Teruru-52/Mercury-pcb/v3.0/dxf/blmd_v1.dxf

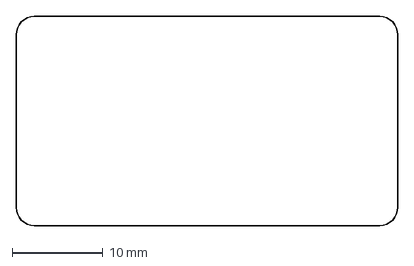
[picture p1: CAD file, 2025-02-25]
v3.0/dxf/blmd_v1.dxf
42.0 x 23.0 mm
