Teruru-52/Mercury-pcb/v3.0/dxf/encoder.dxf

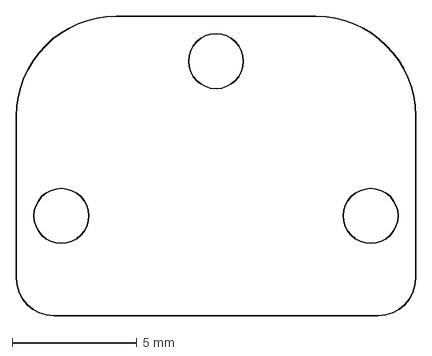
[picture p2: CAD file, 2025-02-25]
v3.0/dxf/encoder.dxf
16.0 x 12.0 mm
