Teruru-52/Mercury-pcb/v1.0/dxf/top_board.dxf

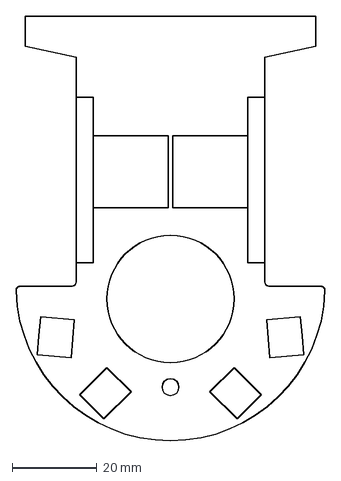
[picture p3: CAD file, 2025-02-25, an earlier design]
v1.0/dxf/top_board.dxf
72.8 x 100.0 mm
