Teruru-52/Mercury-pcb/(list of files, drawings)

Other design files:
v1.0/Quatro.dsn
