Teruru-52/Mercury-pcb/v1.0/Quatro.kicad_pcb

## KiCad design v1.0/Quatro.kicad_pcb (2025-02-25, an earlier design)

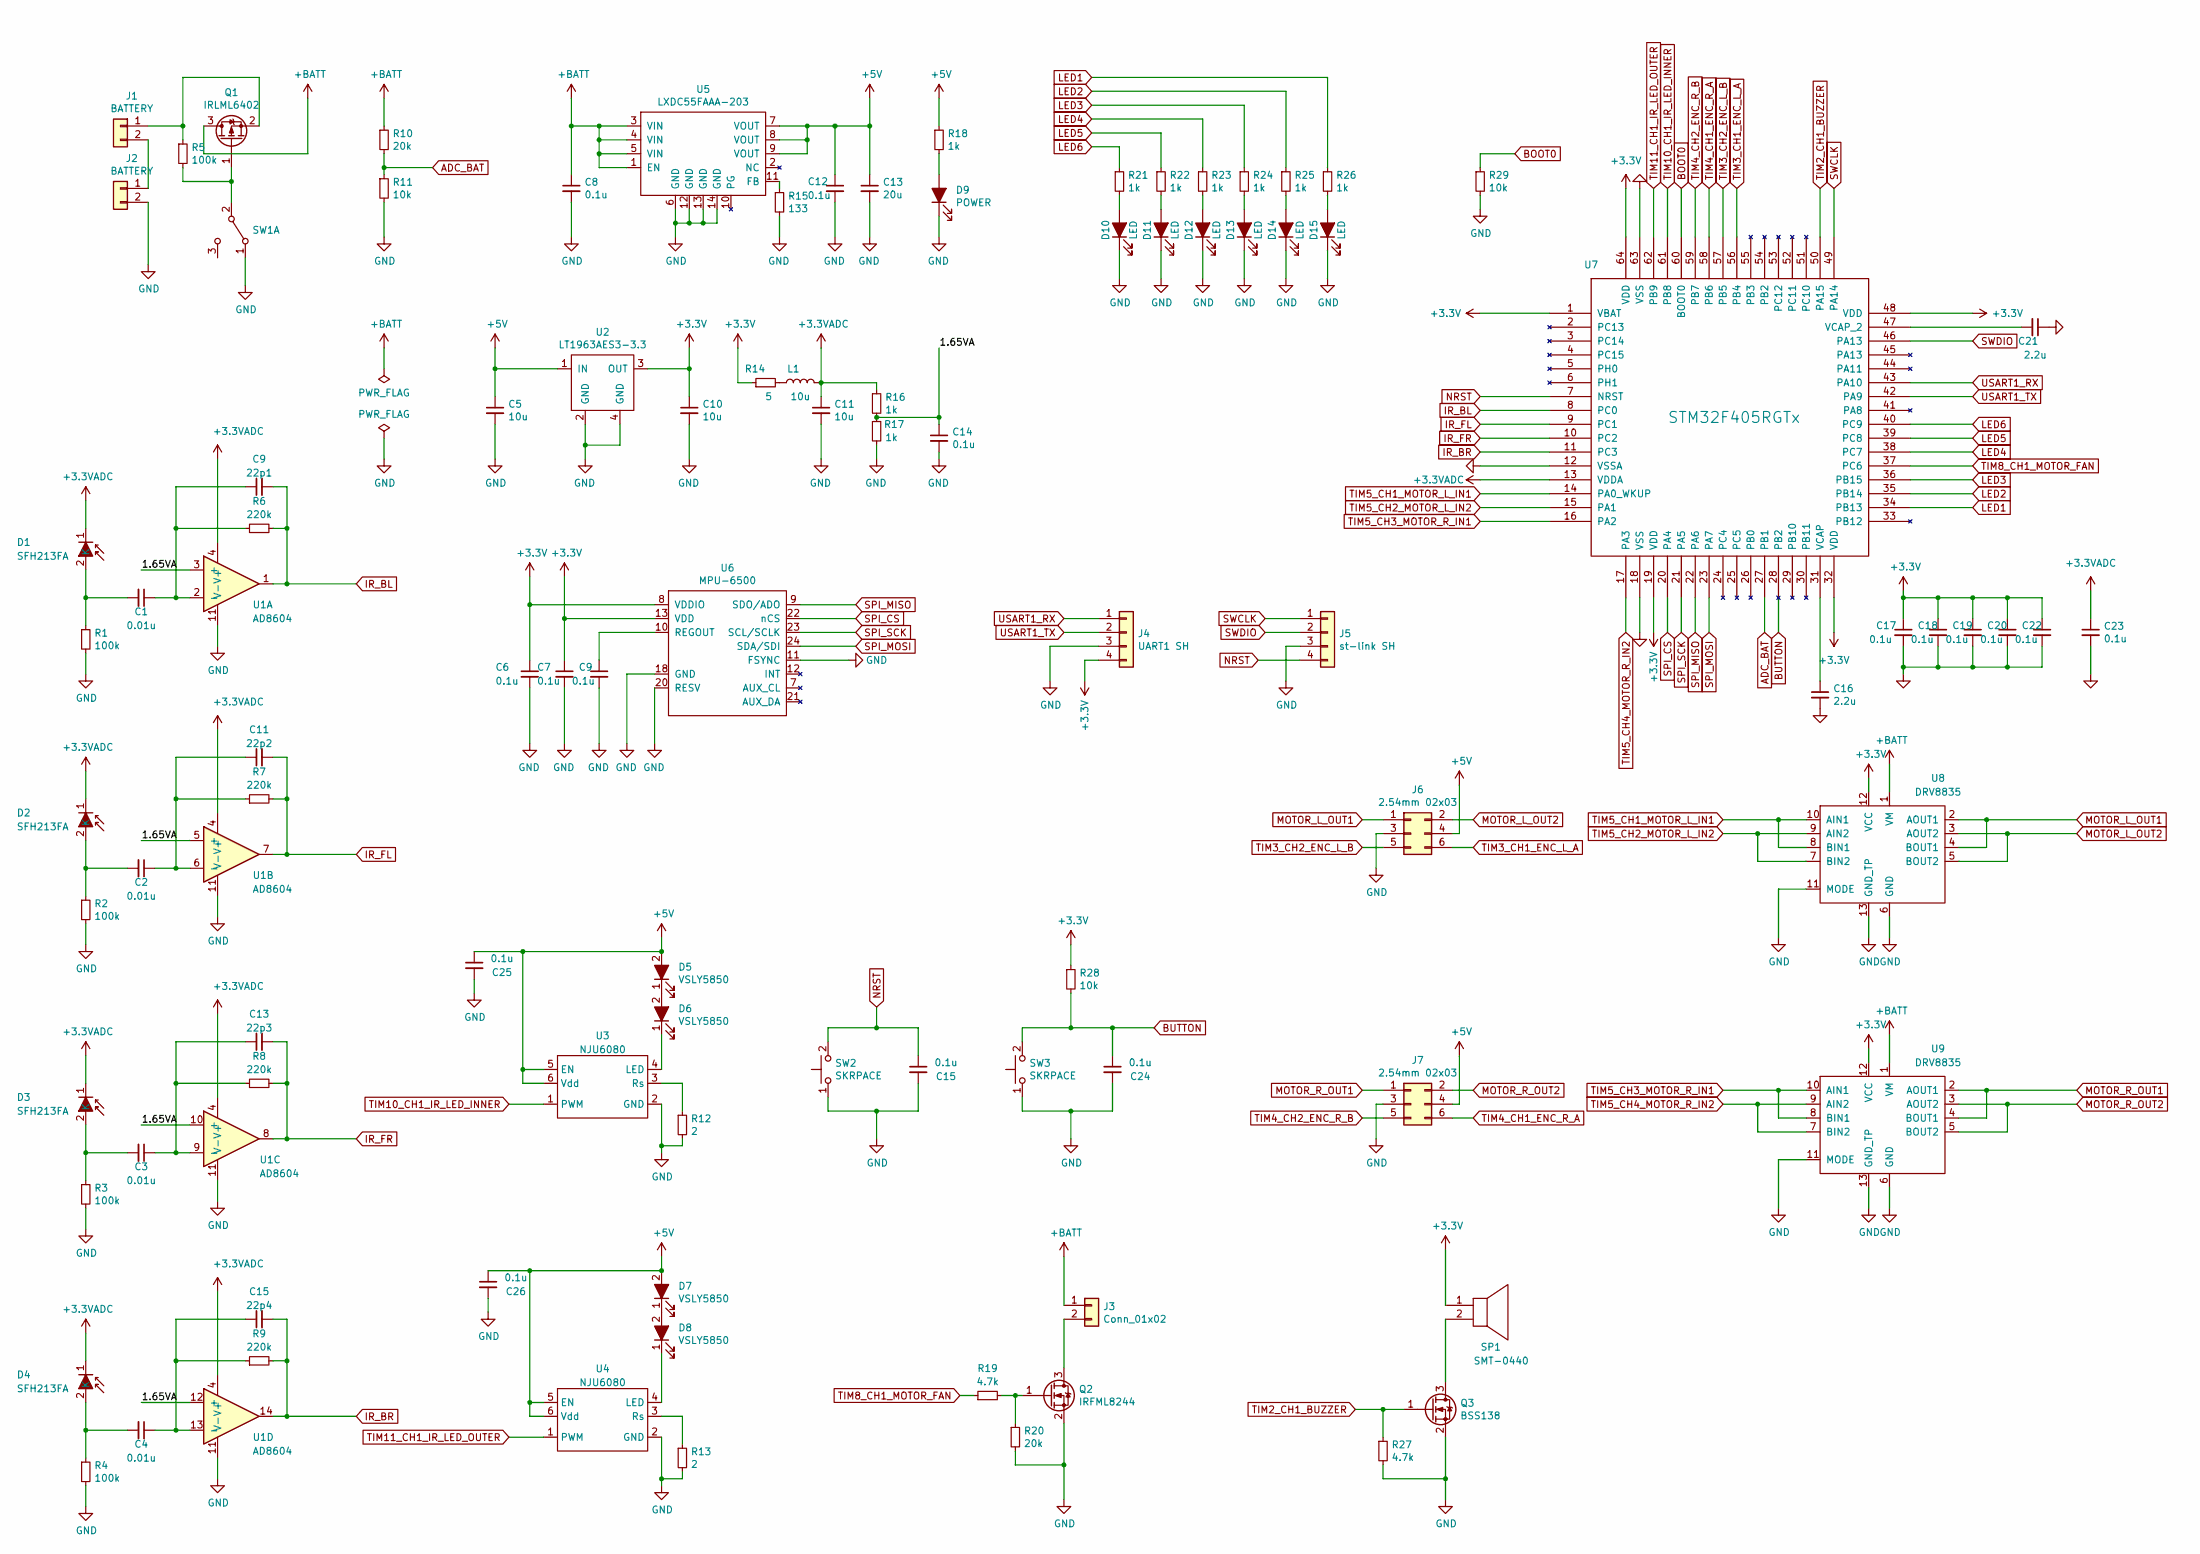
[picture p5: schematic Quatro.kicad_sch]

Parts:
22p1: C9; C_0603_1608Metric_Pad1.08x0.95mm_HandSolder
22p2: C11; C_0603_1608Metric_Pad1.08x0.95mm_HandSolder
22p3: C13; C_0603_1608Metric_Pad1.08x0.95mm_HandSolder
22p4: C15; C_0603_1608Metric_Pad1.08x0.95mm_HandSolder
C1, C2, C3, C4: 0.01u; C_0603_1608Metric_Pad1.08x0.95mm_HandSolder
C5, C10, C11: 10u; C_0603_1608Metric_Pad1.08x0.95mm_HandSolder
C6, C7, C8, C9, C12, C14, C15, C17, C18, C19, C20, C22, C23, C24, C25, C26: 0.1u; C_0603_1608Metric_Pad1.08x0.95mm_HandSolder
C13: 20u; C_0603_1608Metric_Pad1.08x0.95mm_HandSolder
C16, C21: 2.2u; C_0603_1608Metric_Pad1.08x0.95mm_HandSolder
D1, D2, D3, D4: SFH213FA; D_T-1_P2.54mm_Vertical_AnodeUp
D5, D6, D7, D8: VSLY5850; D_T-1_P2.54mm_Vertical_AnodeUp
D9: POWER; LED_0603_1608Metric_Pad1.05x0.95mm_HandSolder
D10, D11, D12, D13, D14, D15: LED; LED_0603_1608Metric_Pad1.05x0.95mm_HandSolder
J1, J2: BATTERY; PinSocket_1x02_P1.27mm_Vertical
J3: Conn_01x02; PinSocket_1x02_P1.27mm_Vertical
J4: UART1 SH; PinHeader_1x04_P2.54mm_Vertical
J5: st-link SH; JST_SH_BM04B-SRSS-TB_1x04-1MP_P1.00mm_Vertical
J6, J7: 2.54mm 02x03; PinHeader_2x03_P2.54mm_Vertical
L1: 10u; L_1210_3225Metric_Pad1.42x2.65mm_HandSolder
Q1: IRLML6402; SOT-23
Q2: IRFML8244; SOT-23
Q3: BSS138; SOT-23
R1, R2, R3, R4, R5: 100k; R_0805_2012Metric_Pad1.20x1.40mm_HandSolder
R6, R7, R8, R9: 220k; R_0603_1608Metric_Pad0.98x0.95mm_HandSolder
R10, R20: 20k; R_0603_1608Metric_Pad0.98x0.95mm_HandSolder
R11, R29: 10k; R_0805_2012Metric_Pad1.20x1.40mm_HandSolder
R12, R13: 2; R_0805_2012Metric_Pad1.20x1.40mm_HandSolder
R14: 5; R_0805_2012Metric_Pad1.20x1.40mm_HandSolder
R15: 133; R_1206_3216Metric_Pad1.30x1.75mm_HandSolder
R16, R17, R18, R21, R22, R23, R24, R25, R26: 1k; R_0805_2012Metric_Pad1.20x1.40mm_HandSolder
R19, R27: 4.7k; R_0603_1608Metric_Pad0.98x0.95mm_HandSolder
R28: 10k; R_0603_1608Metric_Pad0.98x0.95mm_HandSolder
SP1: SMT-0440; SMT-0440-T-R
SW1: SW_DPDT_x2; SlideSwitch
SW2, SW3: SKRPACE; SW_Push_1P1T_NO_Vertical_Wuerth_434133025816
U1: AD8604; TSSOP-14_4.4x5mm_P0.65mm
U2: LT1963AES3-3.3; SOT-223
U3, U4: NJU6080; SOT-23-6_Handsoldering
U5: LXDC55FAAA-203
U6: MPU-6500; QFN-24-1EP_3x3mm_P0.4mm_EP1.75x1.6mm
U7: STM32F405RGTx; LQFP-64_10x10mm_P0.5mm
U8, U9: DRV8835

Connections:
+3.3V: C6.1, C7.1, C10.1, C17.1, C18.1, C19.1, C20.1, C22.1, J4.4, R14.1, R28.1, SP1.1, U2.3 (OUT), U6.8 (VDDIO), U6.13 (VDD), U7.1 (VBAT), U7.19 (VDD), U7.32 (VDD), U7.48 (VDD), U7.64 (VDD), U8.12 (VCC), U9.12 (VCC)
+3.3VADC: C11.1, C23.1, D1.1 (K), D2.1 (K), D3.1 (K), D4.1 (K), L1.2, R16.1, U1.4 (V+), U7.13 (VDDA)
+5V: C5.1, C12.1, C13.1, C25.1, C26.1, D5.2, D7.2, J6.4, J7.4, R18.1, U2.1 (IN), U3.5 (EN), U3.6 (Vdd), U4.5 (EN), U4.6 (Vdd), U5.7 (VOUT), U5.8 (VOUT), U5.9 (VOUT)
+BATT: C8.1, J3.1, Q1.3 (D), R10.1, U5.1 (EN), U5.3 (VIN), U5.4 (VIN), U5.5 (VIN), U8.1 (VM), U9.1 (VM)
/1.65VA: C14.1, R16.2, R17.1, U1.3 (+), U1.5 (+), U1.10 (+), U1.12 (+)
ADC_BAT: R10.2, R11.1, U7.27 (PB1)
BOOT0: R29.1, U7.60 (BOOT0)
BUTTON: C24.1, R28.2, SW3.2, U7.28 (PB2)
GND: C5.2, C6.2, C7.2, C8.2, C9.2, C10.2, C11.2, C12.2, C13.2, C14.2, C15.2, C16.2, C17.2, C18.2, C19.2, C20.2, C21.1, C22.2, C23.2, C24.2, C25.2, C26.2, D9.1 (K), D10.1 (K), D11.1 (K), D12.1 (K), D13.1 (K), D14.1 (K), D15.1 (K), J2.2, J4.3, J5.3, J6.3, J7.3, Q2.2, Q3.2 (S), R1.2, R2.2, R3.2, R4.2, R11.2, R12.2, R13.2, R15.2, R17.2, R20.2, R27.2, R29.2, SW1.1 (A), SW2.1, SW3.1, U1.11 (V-), U2.2 (GND), U2.4 (GND), U3.2 (GND), U4.2 (GND), U5.6 (GND), U5.12 (GND), U5.13 (GND), U5.14 (GND), U6.11 (FSYNC), U6.18 (GND), U6.20 (RESV), U7.12 (VSSA), U7.18 (VSS), U7.63 (VSS), U8.6 (GND), U8.11 (MODE), U8.13 (GND_TP), U9.6 (GND), U9.11 (MODE), U9.13 (GND_TP)
IR_BL: 22p1.2, R6.2, U1.1, U7.8 (PC0)
IR_BR: 22p4.2, R9.2, U1.14, U7.11 (PC3)
IR_FL: 22p2.2, R7.2, U1.7, U7.9 (PC1)
IR_FR: 22p3.2, R8.2, U1.8, U7.10 (PC2)
LED1: R26.1, U7.34 (PB13)
LED2: R25.1, U7.35 (PB14)
LED3: R24.1, U7.36 (PB15)
LED4: R23.1, U7.38 (PC7)
LED5: R22.1, U7.39 (PC8)
LED6: R21.1, U7.40 (PC9)
MOTOR_L_OUT1: J6.1, U8.2 (AOUT1), U8.4 (BOUT1)
MOTOR_L_OUT2: J6.2, U8.3 (AOUT2), U8.5 (BOUT2)
MOTOR_R_OUT1: J7.1, U9.2 (AOUT1), U9.4 (BOUT1)
MOTOR_R_OUT2: J7.2, U9.3 (AOUT2), U9.5 (BOUT2)
NRST: C15.1, J5.4, SW2.2, U7.7 (NRST)
unnamed: 22p1.1, C1.1, R6.1, U1.2 (-)
unnamed: 22p2.1, C2.1, R7.1, U1.6 (-)
unnamed: 22p3.1, C3.1, R8.1, U1.9 (-)
unnamed: 22p4.1, C4.1, R9.1, U1.13 (-)
unnamed: C1.2, D1.2, R1.1
unnamed: C2.2, D2.2, R2.1
unnamed: C3.2, D3.2, R3.1
unnamed: C4.2, D4.2, R4.1
unnamed: C9.1, U6.10 (REGOUT)
unnamed: C16.1, U7.31 (VCAP)
unnamed: C21.2, U7.47 (VCAP_2)
unnamed: D5.1, D6.2
unnamed: D6.1, U3.4 (LED)
unnamed: D7.1, D8.2
unnamed: D8.1, U4.4 (LED)
unnamed: D9.2 (A), R18.2
unnamed: D10.2 (A), R21.2
unnamed: D11.2 (A), R22.2
unnamed: D12.2 (A), R23.2
unnamed: D13.2 (A), R24.2
unnamed: D14.2 (A), R25.2
unnamed: D15.2 (A), R26.2
unnamed: J1.1, Q1.2 (S), R5.1
unnamed: J1.2, J2.1
unnamed: J3.2, Q2.3
unnamed: L1.1, R14.2
unnamed: Q1.1 (G), R5.2, SW1.2 (B)
unnamed: Q2.1, R19.2, R20.1
unnamed: Q3.3 (D), SP1.2
unnamed: R12.1, U3.3 (Rs)
unnamed: R13.1, U4.3 (Rs)
unnamed: R15.1, U5.11 (FB)
SPI_CS: U6.22 (nCS), U7.20 (PA4)
SPI_MISO: U6.9 (SDO/ADO), U7.22 (PA6)
SPI_MOSI: U6.24 (SDA/SDI), U7.23 (PA7)
SPI_SCK: U6.23 (SCL/SCLK), U7.21 (PA5)
SWCLK: J5.1, U7.49 (PA14)
SWDIO: J5.2, U7.46 (PA13)
TIM2_CH1_BUZZER: Q3.1 (G), R27.1, U7.50 (PA15)
TIM3_CH1_ENC_L_A: J6.6, U7.56 (PB4)
TIM3_CH2_ENC_L_B: J6.5, U7.57 (PB5)
TIM4_CH1_ENC_R_A: J7.6, U7.58 (PB6)
TIM4_CH2_ENC_R_B: J7.5, U7.59 (PB7)
TIM5_CH1_MOTOR_L_IN1: U7.14 (PA0_WKUP), U8.8 (BIN1), U8.10 (AIN1)
TIM5_CH2_MOTOR_L_IN2: U7.15 (PA1), U8.7 (BIN2), U8.9 (AIN2)
TIM5_CH3_MOTOR_R_IN1: U7.16 (PA2), U9.8 (BIN1), U9.10 (AIN1)
TIM5_CH4_MOTOR_R_IN2: U7.17 (PA3), U9.7 (BIN2), U9.9 (AIN2)
TIM8_CH1_MOTOR_FAN: R19.1, U7.37 (PC6)
TIM10_CH1_IR_LED_INNER: U3.1 (PWM), U7.61 (PB8)
TIM11_CH1_IR_LED_OUTER: U4.1 (PWM), U7.62 (PB9)
USART1_RX: J4.1, U7.43 (PA10)
USART1_TX: J4.2, U7.42 (PA9)

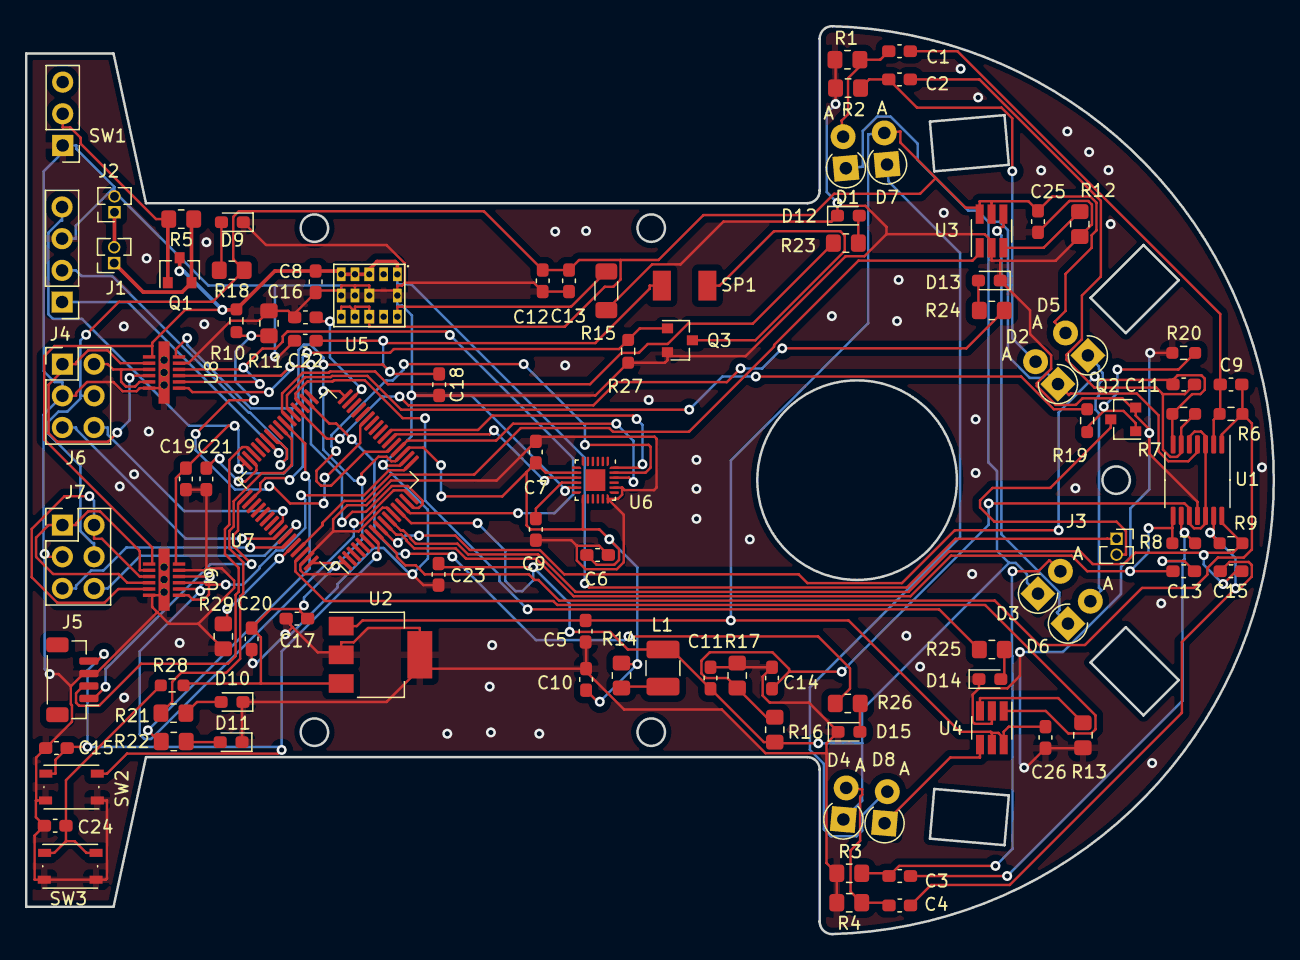
[picture p6: board Quatro.kicad_pcb from above]

Board: 2 copper layers, 100.0 x 72.8 mm, 98 parts (0 on the bottom side), 76 nets.
