Teruru-52/Mercury-pcb/v3.0/encoder/encoder.kicad_pcb

## KiCad design v3.0/encoder/encoder.kicad_pcb (2025-02-25)

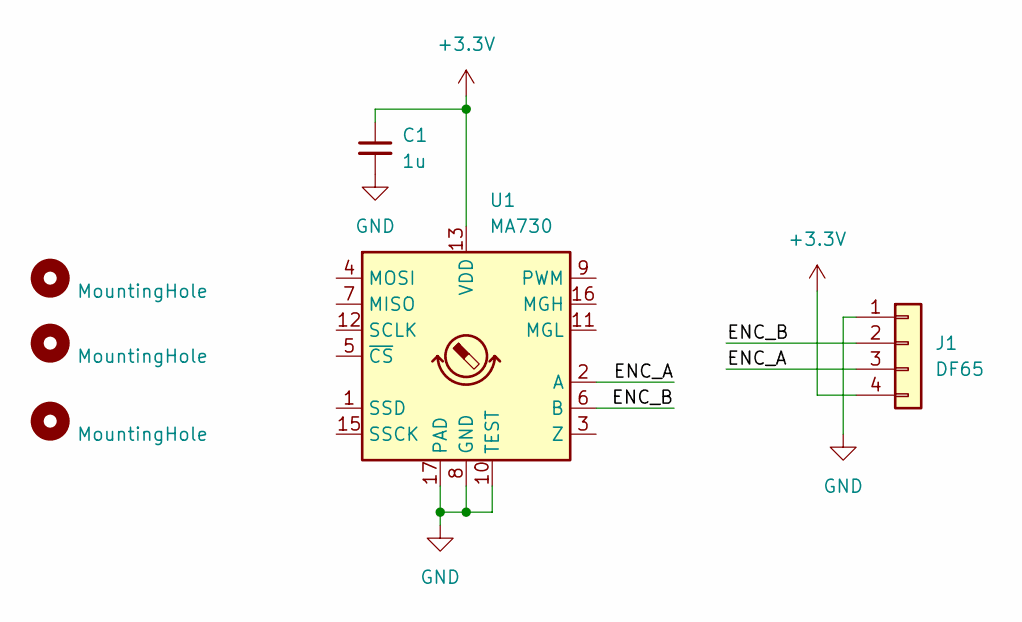
[picture p7: schematic encoder.kicad_sch]

Parts:
C1: 1u; C_0603_1608Metric
H1, H2, H3: MountingHole; MountingHole_2.2mm_M2
J1: DF65; DF65-4P
U1: MA730; QFN-16-1EP_3x3mm_P0.5mm_EP1.75x1.75mm

Connections:
+3.3V: C1.1, J1.4, U1.13 (VDD)
/ENC_A: J1.3, U1.2 (A)
/ENC_B: J1.2, U1.6 (B)
GND: C1.2, J1.1, U1.8 (GND), U1.10 (TEST), U1.17 (PAD)

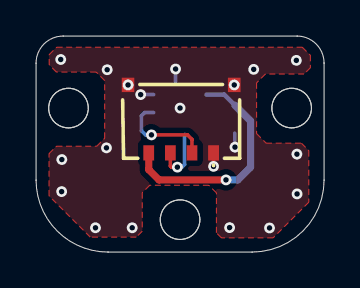
[picture p8: board encoder.kicad_pcb from above]

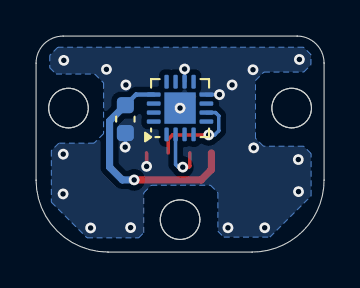
[picture p9: board encoder.kicad_pcb from below]

Board: 2 copper layers, 16.0 x 12.0 mm, 6 parts (2 on the bottom side), 4 nets.
