Teruru-52/Mercury-pcb/v2.1/Mercury-v2.1-pcb.kicad_pcb

## KiCad design v2.1/Mercury-v2.1-pcb.kicad_pcb (2025-02-25, an earlier design)

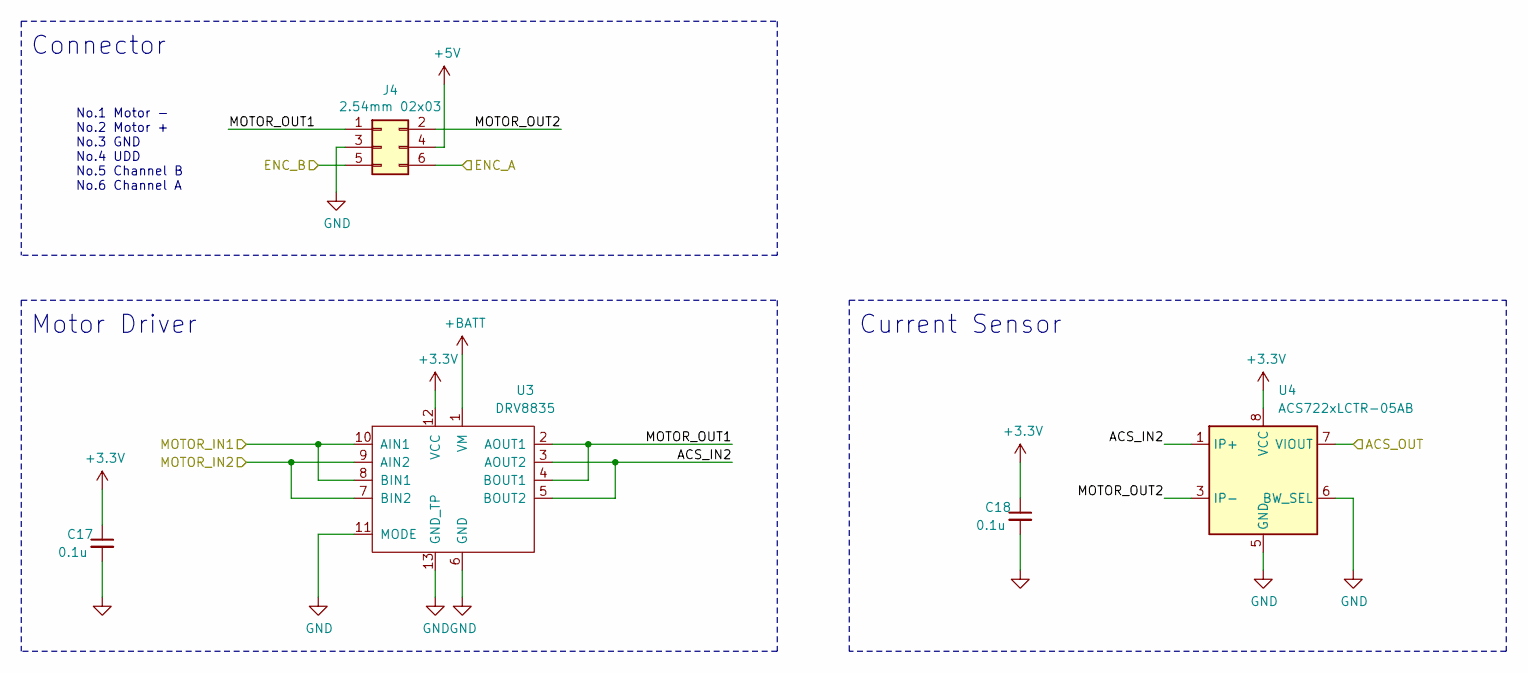
[picture p10: schematic motor_driver.kicad_sch]

Parts:
C17, C18: 0.1u; C_0201_0603Metric
J4: 2.54mm 02x03; PinHeader_2x03_P2.54mm_Vertical
U3: DRV8835; DRV8835DSSR
U4: ACS722xLCTR-05AB; SOIC-8_3.9x4.9mm_P1.27mm

Connections:
+3.3V: C17.1, C18.1, U3.12 (VCC), U4.8 (VCC); also elsewhere on the board
+5V: J4.4; also elsewhere on the board
+BATT: U3.1 (VM); also elsewhere on the board
/mcu/ACS_IN_L: U4.7 (VIOUT); also elsewhere on the board
/mcu/ENC_L_A: J4.6; also elsewhere on the board
/mcu/END_L_B: J4.5; also elsewhere on the board
/mcu/MOTOR_L_IN1: U3.8 (BIN1), U3.10 (AIN1); also elsewhere on the board
/mcu/MOTOR_L_IN2: U3.7 (BIN2), U3.9 (AIN2); also elsewhere on the board
/motor_driver L/ACS_IN2: U3.3 (AOUT2), U3.5 (BOUT2), U4.1 (IP+), U4.2 (IP+)
/motor_driver L/MOTOR_OUT1: J4.1, U3.2 (AOUT1), U3.4 (BOUT1)
/motor_driver L/MOTOR_OUT2: J4.2, U4.3 (IP-), U4.4 (IP-)
GND: C17.2, C18.2, J4.3, U3.6 (GND), U3.11 (MODE), U3.13 (GND_TP), U4.5 (GND), U4.6 (BW_SEL); also elsewhere on the board

Parts of its further copies:
C39, C40: 0.1u; C_0201_0603Metric
J7: 2.54mm 02x03; PinHeader_2x03_P2.54mm_Vertical
U11: DRV8835; DRV8835DSSR
U12: ACS722xLCTR-05AB; SOIC-8_3.9x4.9mm_P1.27mm

Connections of its further copies:
+3.3V: C39.1, C40.1, U11.12 (VCC), U12.8 (VCC); also elsewhere on the board
+5V: J7.4; also elsewhere on the board
+BATT: U11.1 (VM); also elsewhere on the board
/mcu/ACS_IN_R: U12.7 (VIOUT); also elsewhere on the board
/mcu/ENC_R_A: J7.6; also elsewhere on the board
/mcu/END_R_B: J7.5; also elsewhere on the board
/mcu/MOTOR_R_IN1: U11.8 (BIN1), U11.10 (AIN1); also elsewhere on the board
/mcu/MOTOR_R_IN2: U11.7 (BIN2), U11.9 (AIN2); also elsewhere on the board
/motor_driver R/ACS_IN2: U11.3 (AOUT2), U11.5 (BOUT2), U12.1 (IP+), U12.2 (IP+)
/motor_driver R/MOTOR_OUT1: J7.1, U11.2 (AOUT1), U11.4 (BOUT1)
/motor_driver R/MOTOR_OUT2: J7.2, U12.3 (IP-), U12.4 (IP-)
GND: C39.2, C40.2, J7.3, U11.6 (GND), U11.11 (MODE), U11.13 (GND_TP), U12.5 (GND), U12.6 (BW_SEL); also elsewhere on the board

Notes on the sheet:
Connector
No.1 Motor - No.2 Motor + No.3 GND No.4 UDD No.5 Channel B No.6 Channel A
Current Sensor
Motor Driver

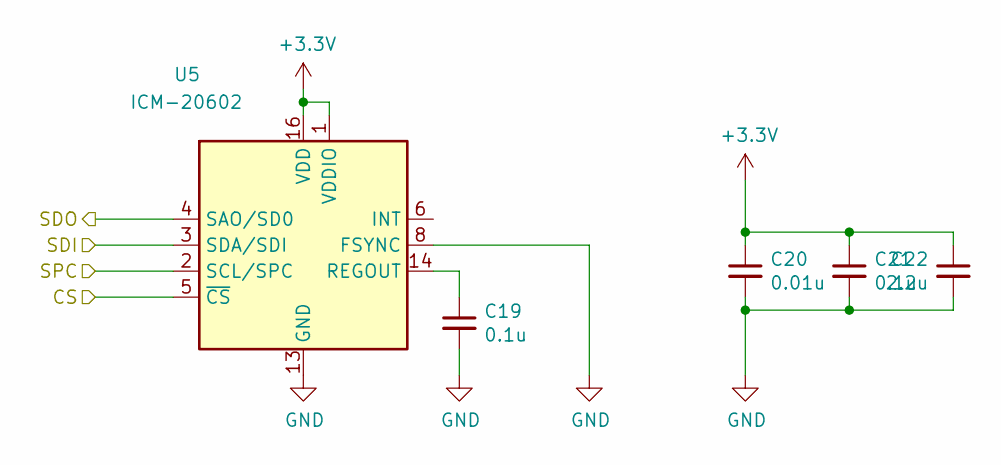
[picture p11: schematic imu.kicad_sch]

Parts:
C19, C21: 0.1u; C_0201_0603Metric
C20: 0.01u; C_0201_0603Metric
C22: 2.2u; C_0402_1005Metric
U5: ICM-20602; LGA-16_3x3mm_P0.5mm_LayoutBorder3x5y

Connections:
+3.3V: C20.1, C21.1, C22.1, U5.1 (VDDIO), U5.16 (VDD); also elsewhere on the board
/imu/CS: U5.5 (~CS); also elsewhere on the board
/imu/SDI: U5.3 (SDA/SDI); also elsewhere on the board
/imu/SDO: U5.4 (SAO/SD0); also elsewhere on the board
/imu/SPC: U5.2 (SCL/SPC); also elsewhere on the board
GND: C19.2, C20.2, C21.2, C22.2, U5.8 (FSYNC), U5.9 (GND), U5.10 (GND), U5.11 (GND), U5.12 (GND), U5.13 (GND), U5.15 (GND); also elsewhere on the board
unnamed: C19.1, U5.14 (REGOUT)

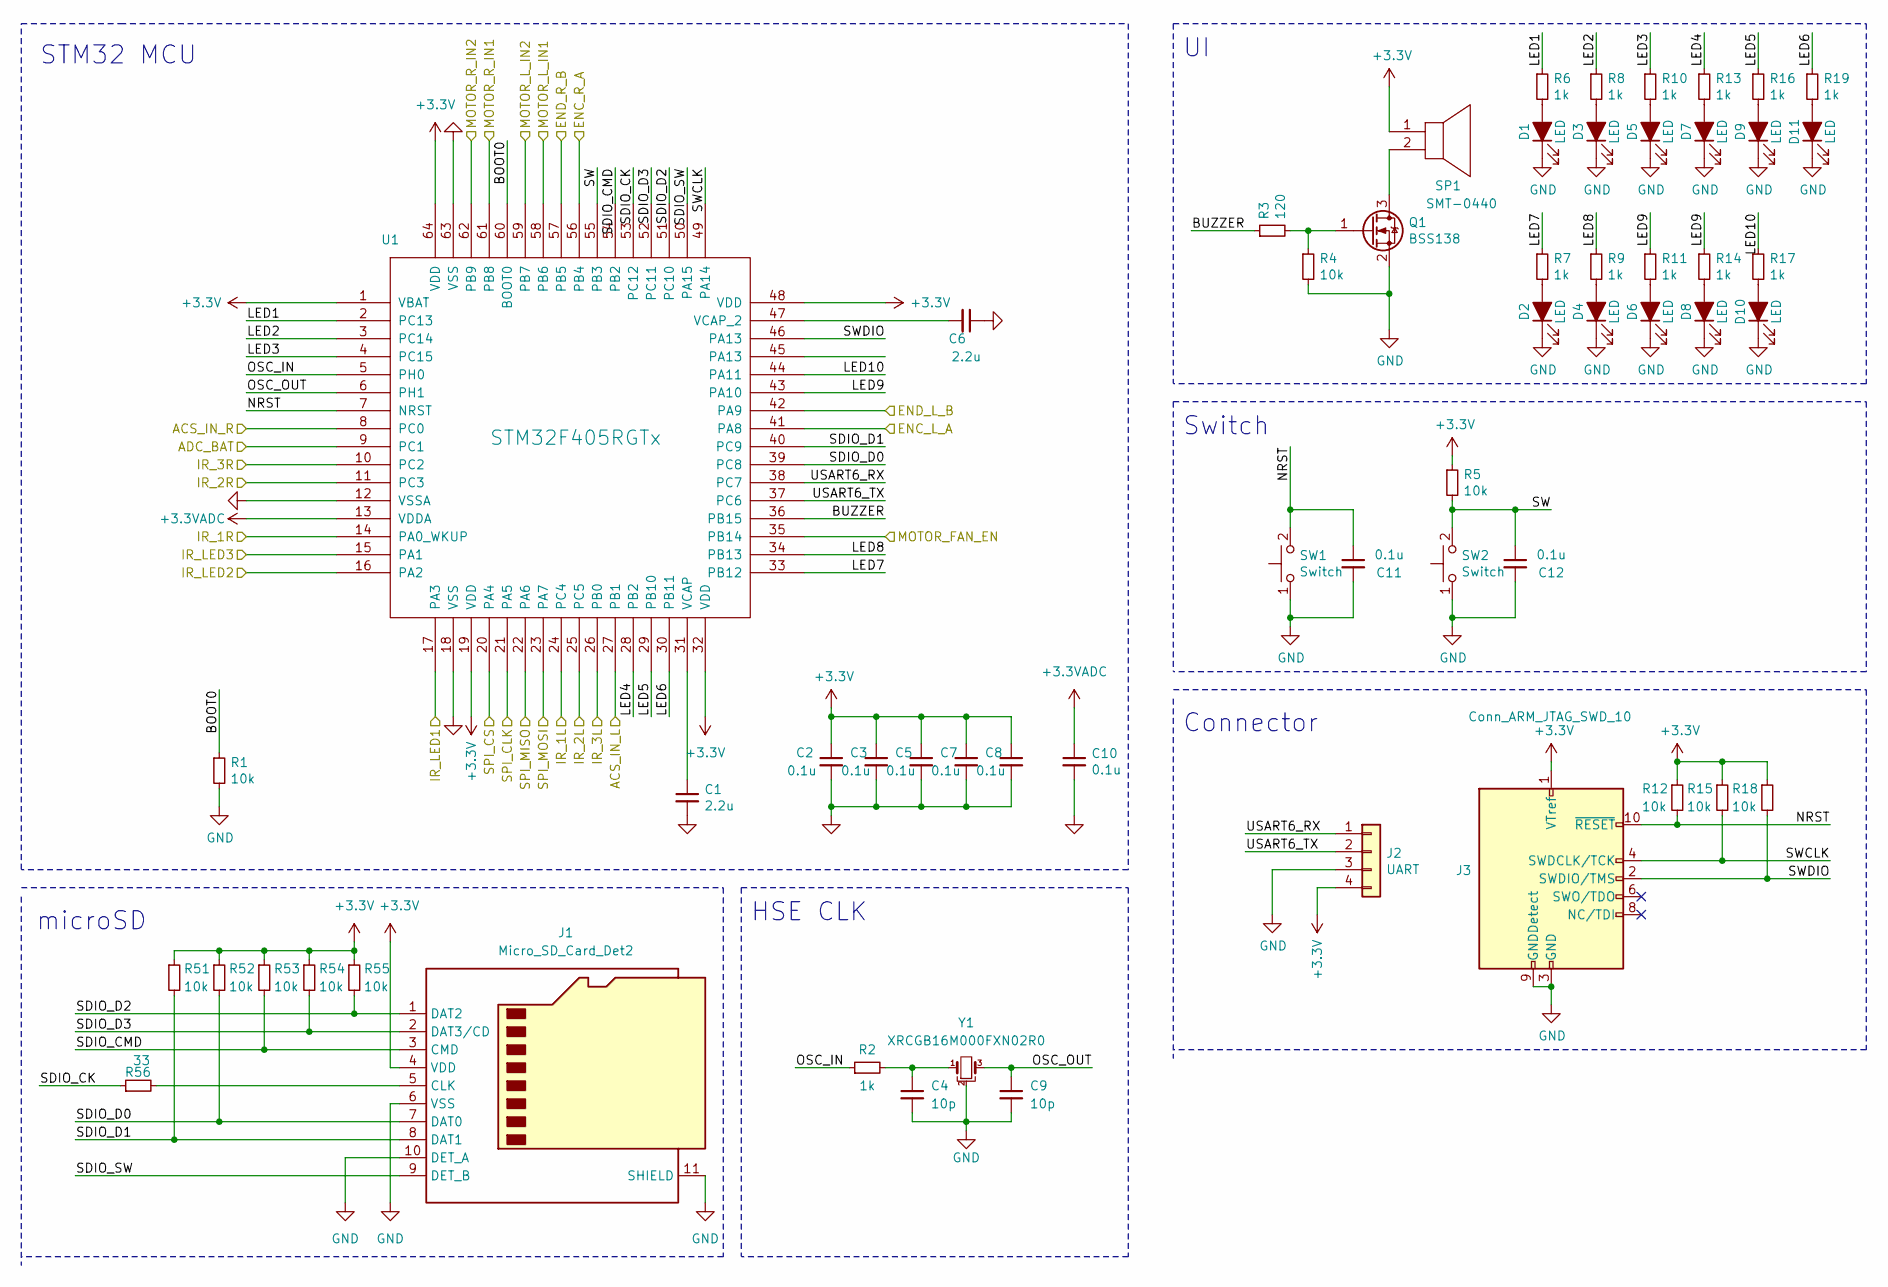
[picture p12: schematic mcu.kicad_sch]

Parts:
C1, C6: 2.2u; C_0402_1005Metric
C2, C3, C5, C7, C8, C10, C11, C12: 0.1u; C_0201_0603Metric
C4, C9: 10p; C_0402_1005Metric_Pad0.74x0.62mm_HandSolder
D1, D2, D3, D4, D5, D6, D7, D8, D9, D10, D11: LED; LED_0402_1005Metric
J1: Micro_SD_Card_Det2; microSD_HC_Hirose_DM3AT-SF-PEJM5
J2: UART; PinHeader_1x04_P2.54mm_Vertical
J3: Conn_ARM_JTAG_SWD_10; mylib
Q1: BSS138; SOT-23
R1, R4, R5, R12, R15, R18, R51, R52, R53, R54, R55: 10k; R_0201_0603Metric
R2: 1k; R_0402_1005Metric_Pad0.72x0.64mm_HandSolder
R3: 120; R_0201_0603Metric
R6, R7, R8, R9, R10, R11, R13, R14, R16, R17, R19: 1k; R_0201_0603Metric
R56: 33; R_0201_0603Metric
SP1: SMT-0440
SW1, SW2: Switch; TVAF06A020BR
U1: STM32F405RGTx; LQFP-64_10x10mm_P0.5mm
Y1: XRCGB16M000FXN02R0

Connections:
+3.3V: C2.1, C3.1, C5.1, C7.1, C8.1, J1.4 (VDD), J2.4, J3.1 (VTref), R5.1, R12.1, R15.1, R18.1, R51.1, R52.1, R53.1, R54.1, R55.1, SP1.1, U1.1 (VBAT), U1.19 (VDD), U1.32 (VDD), U1.48 (VDD), U1.64 (VDD); also elsewhere on the board
+3.3VADC: C10.1, U1.13 (VDDA); also elsewhere on the board
/fan_driver/MOTOR_FAN_EN: U1.35 (PB14); also elsewhere on the board
/imu/CS: U1.20 (PA4); also elsewhere on the board
/imu/SDI: U1.23 (PA7); also elsewhere on the board
/imu/SDO: U1.22 (PA6); also elsewhere on the board
/imu/SPC: U1.21 (PA5); also elsewhere on the board
/ir_led/IR_LED_IN1: U1.16 (PA2); also elsewhere on the board
/ir_led/IR_LED_IN2: U1.15 (PA1); also elsewhere on the board
/ir_led_single/IR_LED_IN: U1.17 (PA3); also elsewhere on the board
/ir_sensor1/IR_OUT_A: U1.11 (PC3); also elsewhere on the board
/ir_sensor1/IR_OUT_B: U1.25 (PC5); also elsewhere on the board
/ir_sensor2/IR_OUT_A: U1.10 (PC2); also elsewhere on the board
/ir_sensor2/IR_OUT_B: U1.26 (PB0); also elsewhere on the board
/ir_sensor/IR_OUT_A: U1.14 (PA0_WKUP); also elsewhere on the board
/ir_sensor/IR_OUT_B: U1.24 (PC4); also elsewhere on the board
/mcu/ACS_IN_L: U1.27 (PB1); also elsewhere on the board
/mcu/ACS_IN_R: U1.8 (PC0); also elsewhere on the board
/mcu/ADC_BAT: U1.9 (PC1); also elsewhere on the board
/mcu/BOOT0: R1.1, U1.60 (BOOT0)
/mcu/BUZZER: R3.1, U1.36 (PB15)
/mcu/ENC_L_A: U1.41 (PA8); also elsewhere on the board
/mcu/ENC_R_A: U1.56 (PB4); also elsewhere on the board
/mcu/END_L_B: U1.42 (PA9); also elsewhere on the board
/mcu/END_R_B: U1.57 (PB5); also elsewhere on the board
/mcu/LED1: R6.1, U1.2 (PC13)
/mcu/LED2: R8.1, U1.3 (PC14)
/mcu/LED3: R10.1, U1.4 (PC15)
/mcu/LED4: R13.1, U1.28 (PB2)
/mcu/LED5: R16.1, U1.29 (PB10)
/mcu/LED6: R19.1, U1.30 (PB11)
/mcu/LED7: R7.1, U1.33 (PB12)
/mcu/LED8: R9.1, U1.34 (PB13)
/mcu/LED9: R11.1, R14.1, U1.43 (PA10)
/mcu/LED10: R17.1, U1.44 (PA11)
/mcu/MOTOR_L_IN1: U1.58 (PB6); also elsewhere on the board
/mcu/MOTOR_L_IN2: U1.59 (PB7); also elsewhere on the board
/mcu/MOTOR_R_IN1: U1.61 (PB8); also elsewhere on the board
/mcu/MOTOR_R_IN2: U1.62 (PB9); also elsewhere on the board
/mcu/NRST: C11.1, J3.10 (~RESET), R12.2, SW1.2, U1.7 (NRST)
/mcu/OSC_IN: R2.1, U1.5 (PH0)
/mcu/OSC_OUT: C9.1, U1.6 (PH1), Y1.3
/mcu/SDIO_CK: R56.1, U1.53 (PC12)
/mcu/SDIO_CMD: J1.3 (CMD), R53.2, U1.54 (PB2)
/mcu/SDIO_D0: J1.7 (DAT0), R52.2, U1.39 (PC8)
/mcu/SDIO_D1: J1.8 (DAT1), R51.2, U1.40 (PC9)
/mcu/SDIO_D2: J1.1 (DAT2), R55.2, U1.51 (PC10)
/mcu/SDIO_D3: J1.2 (DAT3/CD), R54.2, U1.52 (PC11)
/mcu/SDIO_SW: J1.9 (DET_B), U1.50 (PA15)
/mcu/SW: C12.1, R5.2, SW2.2, U1.55 (PB3)
/mcu/SWCLK: J3.4 (SWDCLK/TCK), R15.2, U1.49 (PA14)
/mcu/SWDIO: J3.2 (SWDIO/TMS), R18.2, U1.46 (PA13)
/mcu/USART6_RX: J2.1, U1.38 (PC7)
/mcu/USART6_TX: J2.2, U1.37 (PC6)
GND: C1.2, C2.2, C3.2, C4.2, C5.2, C6.1, C7.2, C8.2, C9.2, C10.2, C11.2, C12.2, D1.1 (K), D2.1 (K), D3.1 (K), D4.1 (K), D5.1 (K), D6.1 (K), D7.1 (K), D8.1 (K), D9.1 (K), D10.1 (K), D11.1 (K), J1.6 (VSS), J1.10 (DET_A), J1.11 (SHIELD), J2.3, J3.3 (GND), J3.5 (GND), J3.9 (GNDDetect), Q1.2 (S), R1.2, R4.2, SW1.1, SW2.1, U1.12 (VSSA), U1.18 (VSS), U1.63 (VSS), Y1.2; also elsewhere on the board
unnamed: C4.1, R2.2, Y1.1
unnamed: D1.2 (A), R6.2
unnamed: D2.2 (A), R7.2
unnamed: D3.2 (A), R8.2
unnamed: D4.2 (A), R9.2
unnamed: D5.2 (A), R10.2
unnamed: D6.2 (A), R11.2
unnamed: D7.2 (A), R13.2
unnamed: D8.2 (A), R14.2
unnamed: D9.2 (A), R16.2
unnamed: D10.2 (A), R17.2
unnamed: D11.2 (A), R19.2
unnamed: J1.5 (CLK), R56.2
unnamed: Q1.3 (D), SP1.2
unnamed: Q1.1 (G), R3.2, R4.1
unnamed: C1.1, U1.31 (VCAP)
unnamed: C6.2, U1.47 (VCAP_2)

Notes on the sheet:
STM32 MCU
microSD
Connector
HSE CLK
Switch

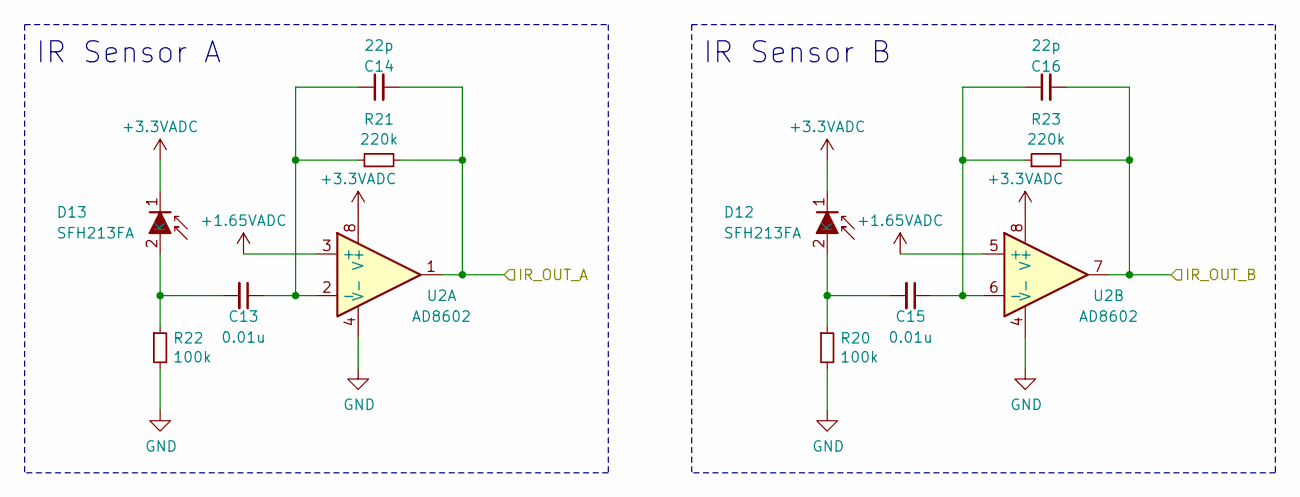
[picture p13: schematic ir_sensor.kicad_sch]

Parts:
C13, C15: 0.01u; C_0201_0603Metric
C14, C16: 22p; C_0201_0603Metric
D12, D13: SFH213FA; D_T-1_P2.54mm_Vertical_AnodeUp
R20, R22: 100k; R_0603_1608Metric
R21, R23: 220k; R_0201_0603Metric
U2: AD8602; MSOP-8_3x3mm_P0.65mm

Connections:
+1.65VADC: U2.3 (+), U2.5 (+); also elsewhere on the board
+3.3VADC: D12.1 (K), D13.1 (K), U2.8 (V+); also elsewhere on the board
/ir_sensor/IR_OUT_A: C14.2, R21.2, U2.1; also elsewhere on the board
/ir_sensor/IR_OUT_B: C16.2, R23.2, U2.7; also elsewhere on the board
GND: R20.2, R22.2, U2.4 (V-); also elsewhere on the board
unnamed: C13.2, D13.2, R22.1
unnamed: C15.2, D12.2, R20.1
unnamed: C13.1, C14.1, R21.1, U2.2 (-)
unnamed: C15.1, C16.1, R23.1, U2.6 (-)

Parts of its further copies:
C31, C33, C35, C37: 0.01u; C_0201_0603Metric
C32, C34, C36, C38: 22p; C_0201_0603Metric
D19, D20, D21, D22: SFH213FA; D_T-1_P2.54mm_Vertical_AnodeUp
R38, R40, R42, R44: 100k; R_0603_1608Metric
R39, R41, R43, R45: 220k; R_0201_0603Metric
U9, U10: AD8602; MSOP-8_3x3mm_P0.65mm

Connections of its further copies:
+1.65VADC: U9.3 (+), U9.5 (+), U10.3 (+), U10.5 (+); also elsewhere on the board
+3.3VADC: D19.1 (K), D20.1 (K), D21.1 (K), D22.1 (K), U9.8 (V+), U10.8 (V+); also elsewhere on the board
/ir_sensor1/IR_OUT_A: C32.2, R39.2, U9.1; also elsewhere on the board
/ir_sensor1/IR_OUT_B: C34.2, R41.2, U9.7; also elsewhere on the board
/ir_sensor2/IR_OUT_A: C36.2, R43.2, U10.1; also elsewhere on the board
/ir_sensor2/IR_OUT_B: C38.2, R45.2, U10.7; also elsewhere on the board
GND: R38.2, R40.2, R42.2, R44.2, U9.4 (V-), U10.4 (V-); also elsewhere on the board
unnamed: C31.2, D20.2, R40.1
unnamed: C33.2, D19.2, R38.1
unnamed: C35.2, D22.2, R44.1
unnamed: C37.2, D21.2, R42.1
unnamed: C31.1, C32.1, R39.1, U9.2 (-)
unnamed: C33.1, C34.1, R41.1, U9.6 (-)
unnamed: C35.1, C36.1, R43.1, U10.2 (-)
unnamed: C37.1, C38.1, R45.1, U10.6 (-)

Notes on the sheet:
IR Sensor B
IR Sensor A

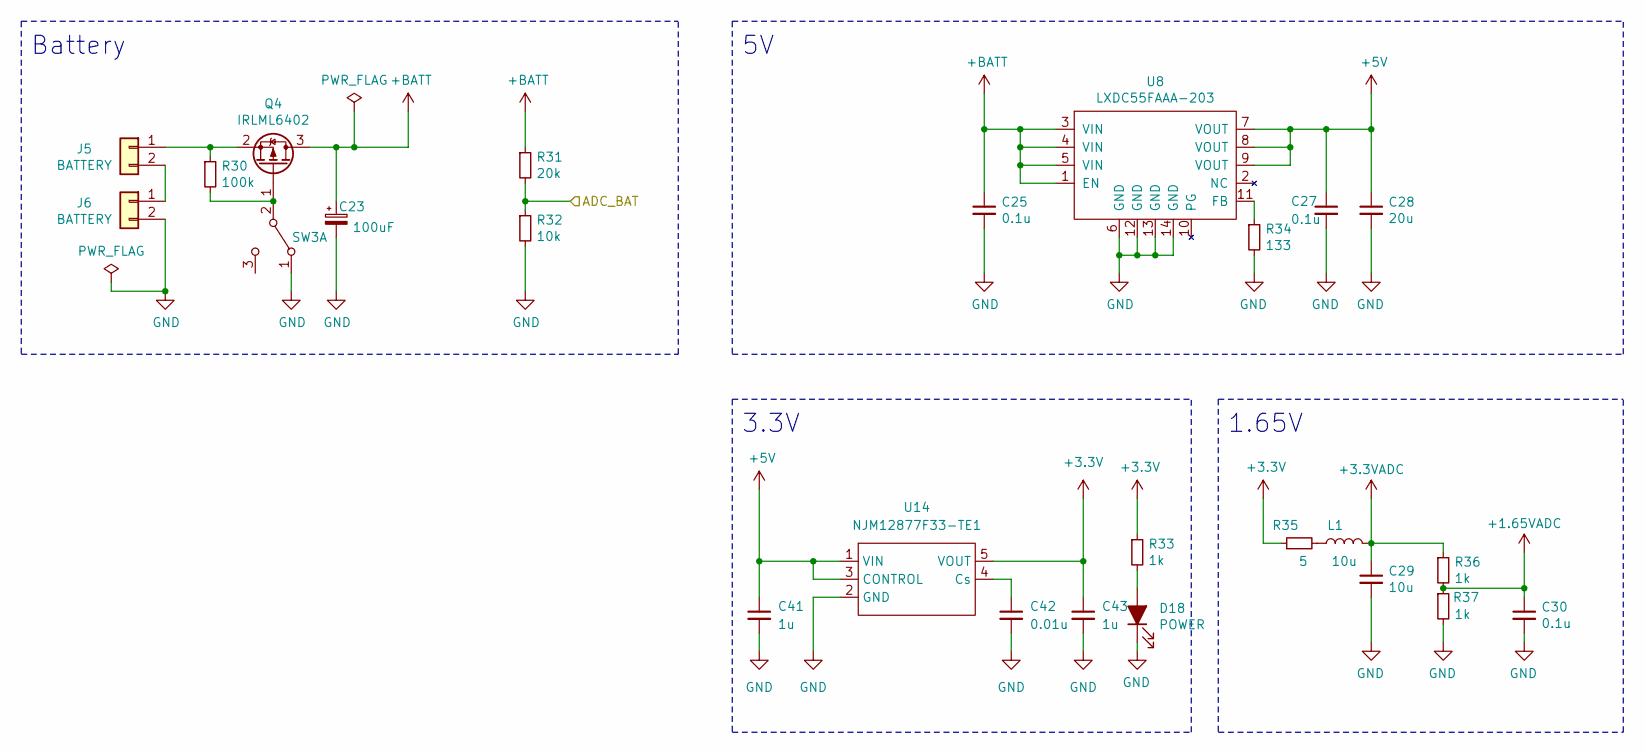
[picture p14: schematic power_supply.kicad_sch]

Parts:
C23: 100uF; CP_Elec_6.3x3
C25, C27: 0.1u; C_0603_1608Metric_Pad1.08x0.95mm_HandSolder
C28: 20u; C_0603_1608Metric_Pad1.08x0.95mm_HandSolder
C29: 10u; C_0603_1608Metric_Pad1.08x0.95mm_HandSolder
C30: 0.1u; C_0201_0603Metric
C41, C43: 1u; C_0603_1608Metric_Pad1.08x0.95mm_HandSolder
C42: 0.01u; C_0603_1608Metric_Pad1.08x0.95mm_HandSolder
D18: POWER; LED_0402_1005Metric
J5, J6: BATTERY; PinSocket_1x02_P1.27mm_Vertical
L1: 10u; L_1008_2520Metric
Q4: IRLML6402; SOT-23
R30: 100k; R_0603_1608Metric
R31: 20k; R_0402_1005Metric
R32: 10k; R_0402_1005Metric
R33: 1k; R_0201_0603Metric
R34: 133; R_1206_3216Metric_Pad1.30x1.75mm_HandSolder
R35: 5; R_0805_2012Metric_Pad1.20x1.40mm_HandSolder
R36, R37: 1k; R_0603_1608Metric
SW3: SW_DPDT_x2; PinHeader_1x03_P2.54mm_Vertical
U8: LXDC55FAAA-203; LXDC55FAAA203
U14: NJM12877F33-TE1; SOT-23-5_HandSoldering

Connections:
+1.65VADC: C30.1, R36.2, R37.1; also elsewhere on the board
+3.3V: C43.1, R33.1, R35.1, U14.5 (VOUT); also elsewhere on the board
+3.3VADC: C29.1, L1.2, R36.1; also elsewhere on the board
+5V: C27.1, C28.1, C41.1, U8.7 (VOUT), U8.8 (VOUT), U8.9 (VOUT), U14.1 (VIN), U14.3 (CONTROL); also elsewhere on the board
+BATT: C23.1, C25.1, Q4.3 (D), R31.1, U8.1 (EN), U8.3 (VIN), U8.4 (VIN), U8.5 (VIN); also elsewhere on the board
/mcu/ADC_BAT: R31.2, R32.1; also elsewhere on the board
GND: C23.2, C25.2, C27.2, C28.2, C29.2, C30.2, C41.2, C42.2, C43.2, D18.1 (K), J6.2, R32.2, R34.2, R37.2, SW3.1 (A), U8.6 (GND), U8.12 (GND), U8.13 (GND), U8.14 (GND), U14.2 (GND); also elsewhere on the board
unnamed: D18.2 (A), R33.2
unnamed: J5.1, Q4.2 (S), R30.1
unnamed: J5.2, J6.1
unnamed: L1.1, R35.2
unnamed: Q4.1 (G), R30.2, SW3.2 (B)
unnamed: R34.1, U8.11 (FB)
unnamed: C42.1, U14.4 (Cs)

Notes on the sheet:
3.3V
1.65V
Battery

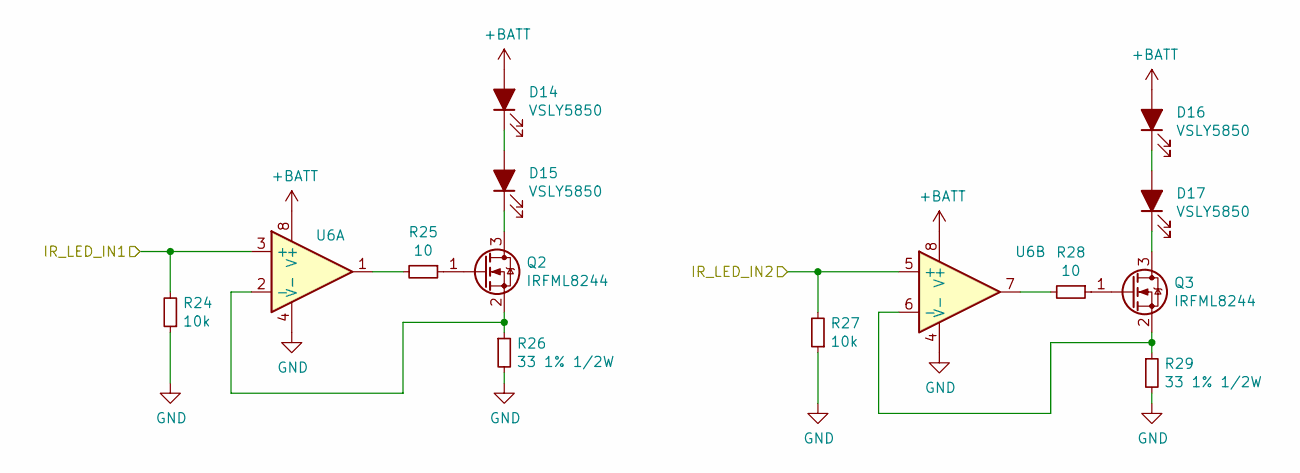
[picture p15: schematic ir_led.kicad_sch]

Parts:
D14, D15, D16, D17: VSLY5850; D_T-1_P2.54mm_Vertical_AnodeUp
Q2, Q3: IRFML8244; SOT-23
R24, R27: 10k; R_0201_0603Metric
R25, R28: 10; R_0603_1608Metric
R26, R29: 33 1% 1/2W; R_0603_1608Metric
U6: SOIC-8_3.9x4.9mm_P1.27mm

Connections:
+BATT: D14.2 (A), D16.2 (A), U6.8 (V+); also elsewhere on the board
/ir_led/IR_LED_IN1: R24.2, U6.3 (+); also elsewhere on the board
/ir_led/IR_LED_IN2: R27.2, U6.5 (+); also elsewhere on the board
GND: R24.1, R26.2, R27.1, R29.2, U6.4 (V-); also elsewhere on the board
unnamed: D14.1 (K), D15.2 (A)
unnamed: D15.1 (K), Q2.3 (D)
unnamed: D16.1 (K), D17.2 (A)
unnamed: D17.1 (K), Q3.3 (D)
unnamed: Q2.1 (G), R25.1
unnamed: Q2.2 (S), R26.1, U6.2 (-)
unnamed: Q3.1 (G), R28.1
unnamed: Q3.2 (S), R29.1, U6.6 (-)
unnamed: R25.2, U6.1
unnamed: R28.2, U6.7
