Teruru-52/Mercury-pcb/v2.1/Mercury-v2.1-pcb.kicad_pcb

## KiCad design v2.1/Mercury-v2.1-pcb.kicad_pcb (continued)

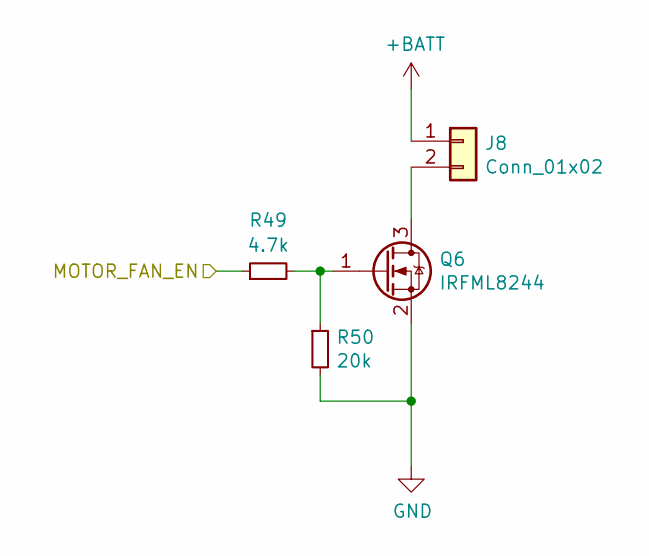
[picture p16: schematic fan_driver.kicad_sch]

Parts:
J8: Conn_01x02; PinSocket_1x02_P1.27mm_Vertical
Q6: IRFML8244; SOT-23
R49: 4.7k; R_0603_1608Metric_Pad0.98x0.95mm_HandSolder
R50: 20k; R_0603_1608Metric_Pad0.98x0.95mm_HandSolder

Connections:
+BATT: J8.1; also elsewhere on the board
/fan_driver/MOTOR_FAN_EN: R49.1; also elsewhere on the board
GND: Q6.2, R50.2; also elsewhere on the board
unnamed: J8.2, Q6.3
unnamed: Q6.1, R49.2, R50.1

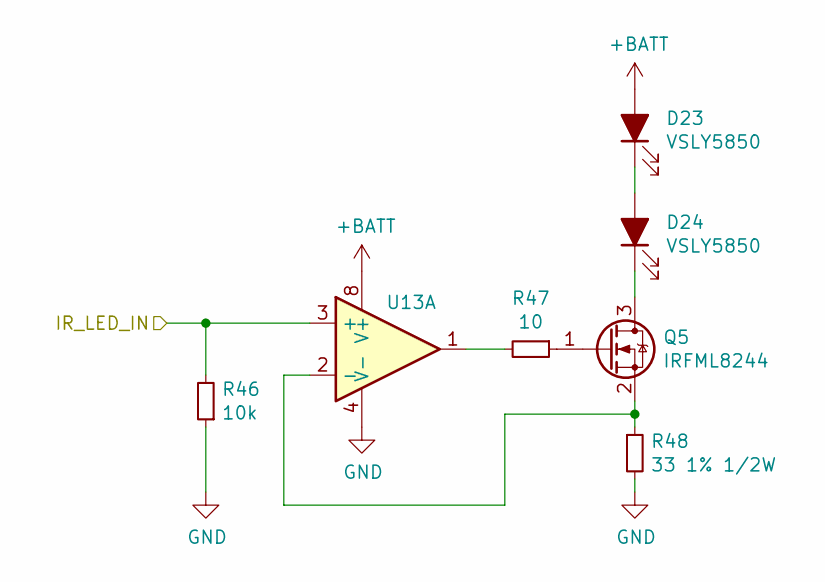
[picture p17: schematic ir_led_single.kicad_sch]

Parts:
D23, D24: VSLY5850; D_T-1_P2.54mm_Vertical_AnodeUp
Q5: IRFML8244; SOT-23
R46: 10k; R_0201_0603Metric
R47: 10; R_0603_1608Metric
R48: 33 1% 1/2W; R_0603_1608Metric
U13: SOIC-8_3.9x4.9mm_P1.27mm

Connections:
+BATT: D23.2 (A), U13.8 (V+); also elsewhere on the board
/ir_led_single/IR_LED_IN: R46.2, U13.3 (+); also elsewhere on the board
GND: R46.1, R48.2, U13.4 (V-); also elsewhere on the board
unnamed: D23.1 (K), D24.2 (A)
unnamed: D24.1 (K), Q5.3 (D)
unnamed: Q5.1 (G), R47.1
unnamed: Q5.2 (S), R48.1, U13.2 (-)
unnamed: R47.2, U13.1

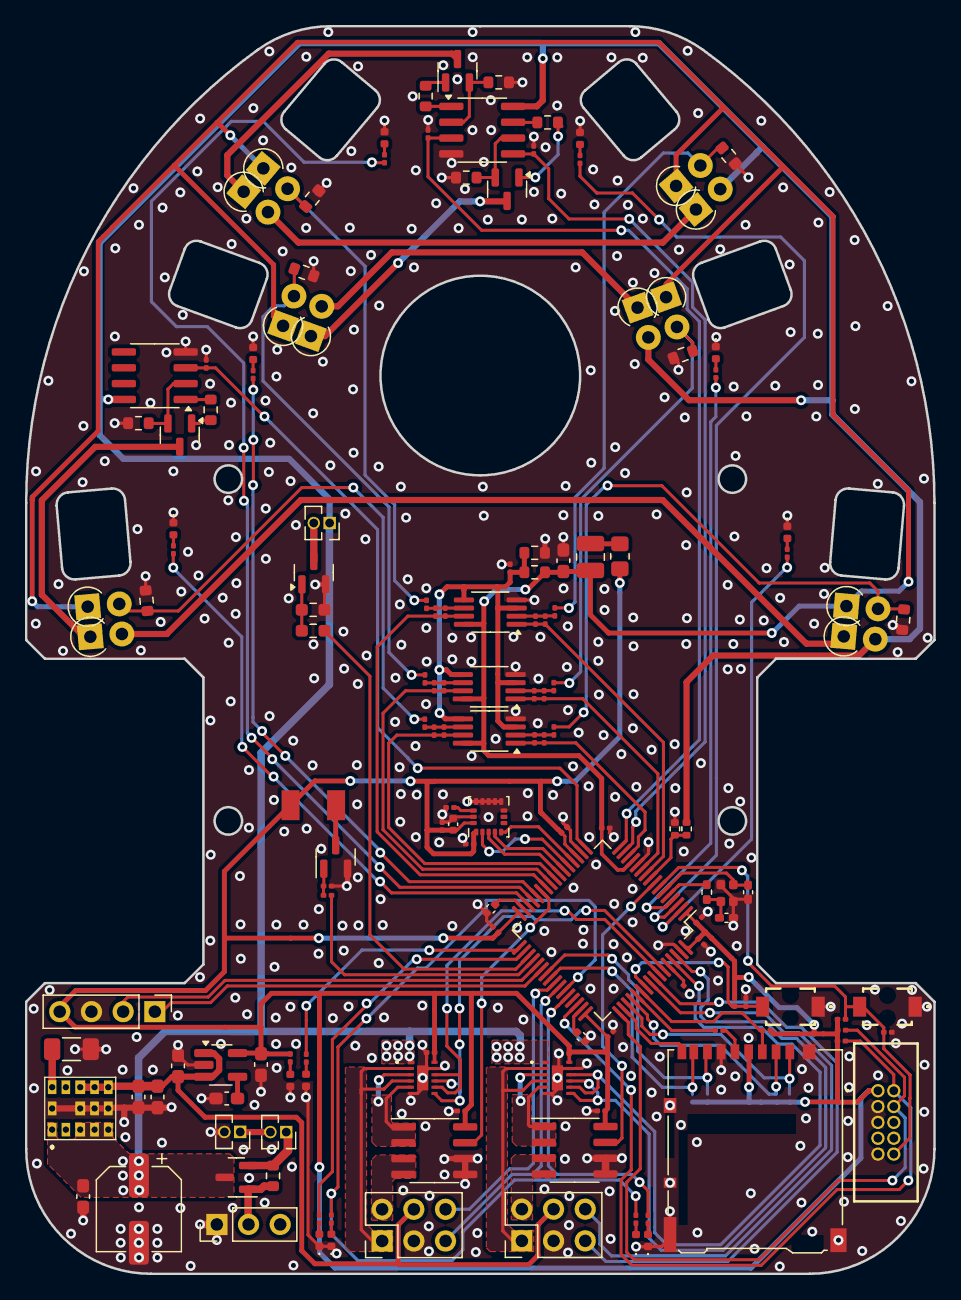
[picture p18: board Mercury-v2.1-pcb.kicad_pcb from above]

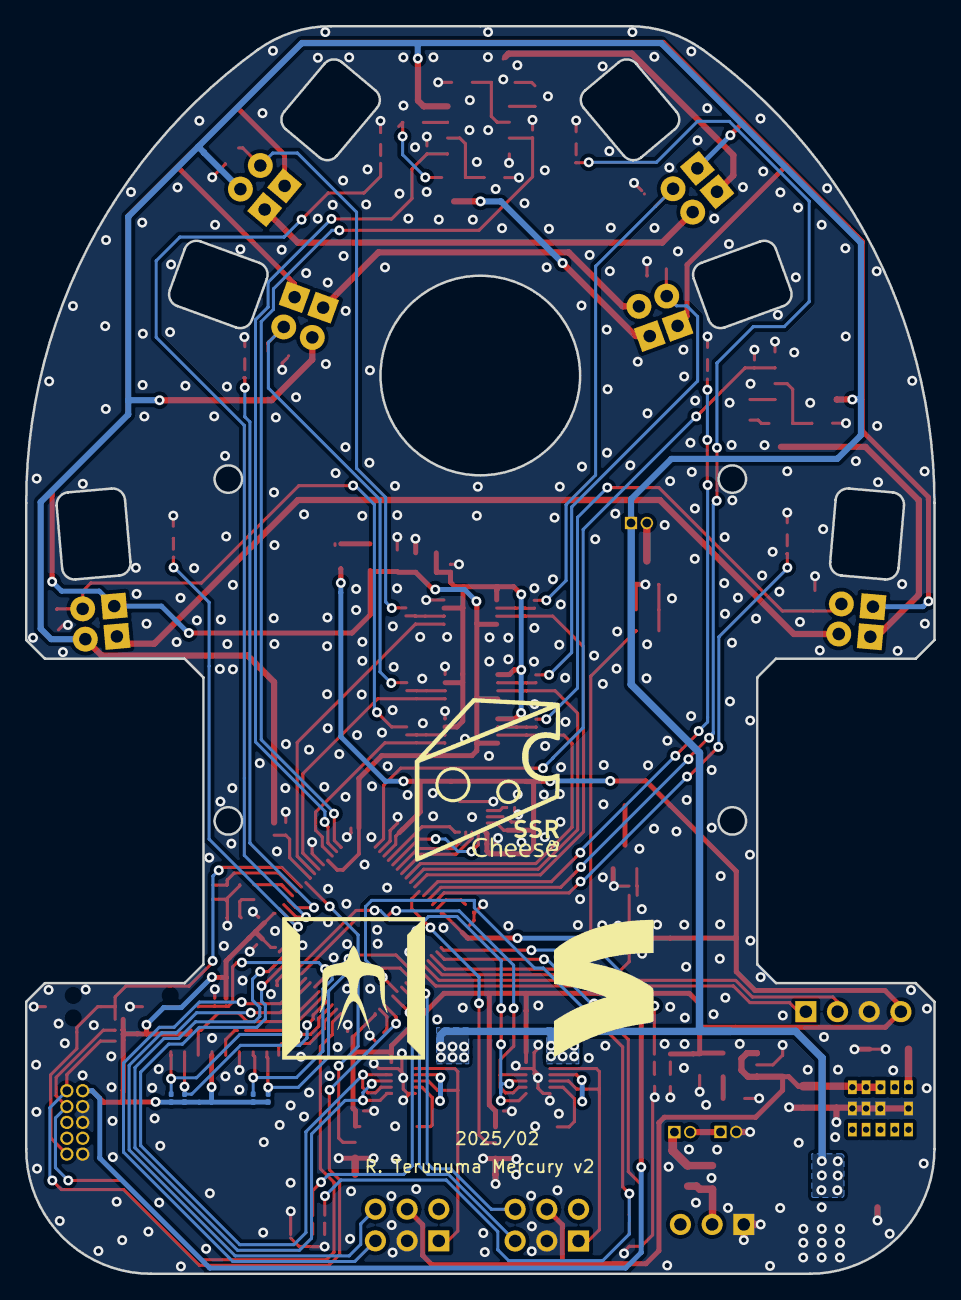
[picture p19: board Mercury-v2.1-pcb.kicad_pcb from below]

Board: 2 copper layers, 72.8 x 100.0 mm, 154 parts (4 on the bottom side), 118 nets.
