Teruru-52/Mercury-pcb/v3.0/blmd/blmd.kicad_pcb

## KiCad design v3.0/blmd/blmd.kicad_pcb (2025-02-25)

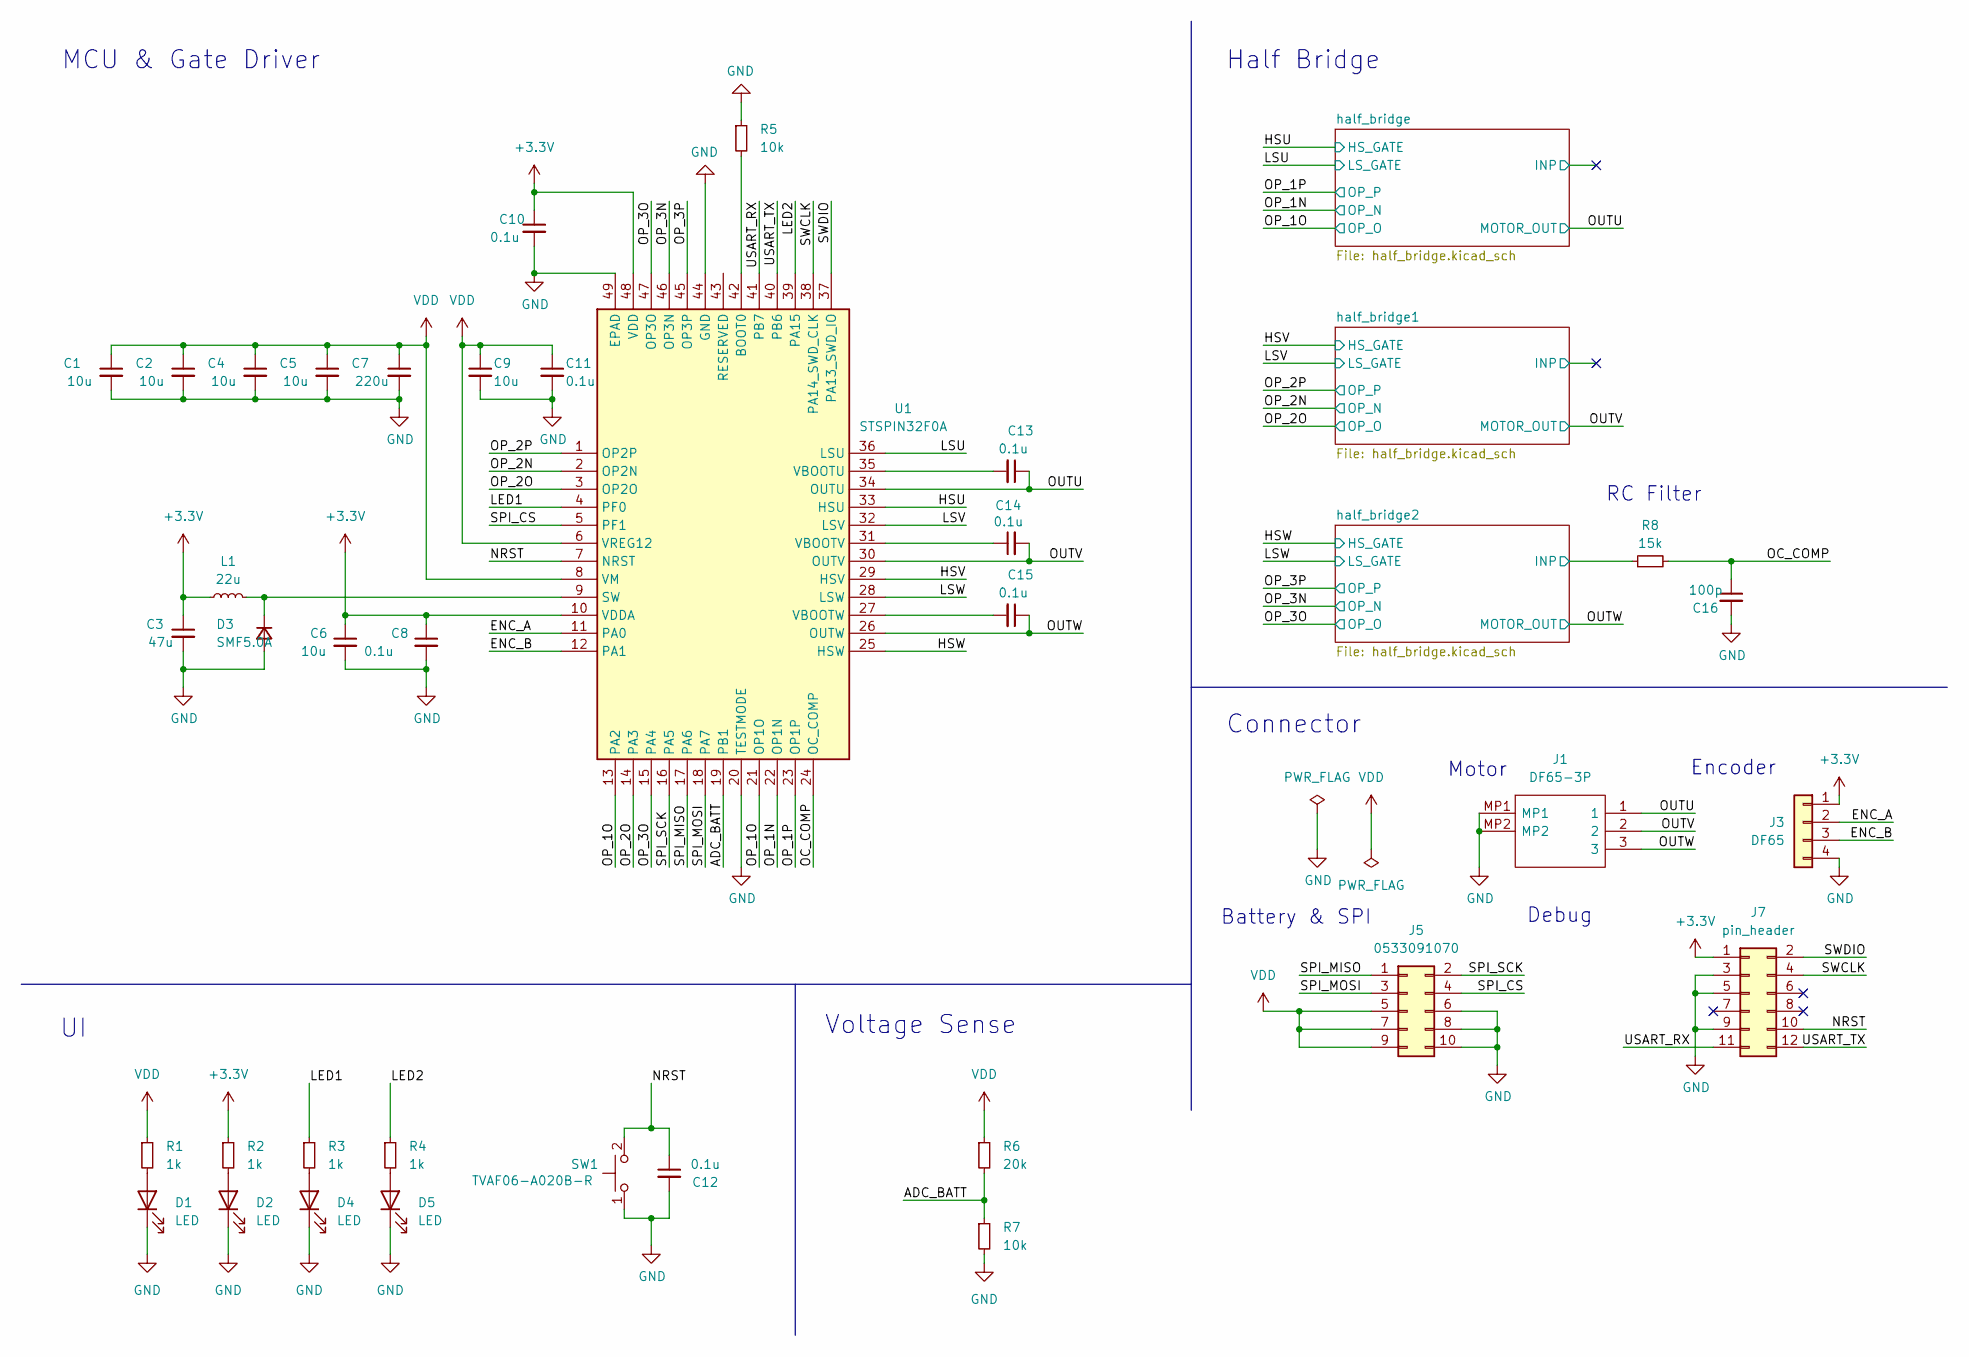
[picture p20: schematic blmd.kicad_sch]

Parts:
C1, C2, C4, C5: 10u; C_0805_2012Metric
C3: 47u; C_0603_1608Metric
C6: 10u; C_0402_1005Metric
C7: 220u; C_0805_2012Metric
C8, C10, C12, C13, C14, C15: 0.1u; C_0201_0603Metric
C9: 10u; C_0603_1608Metric
C11: 0.1u; C_0402_1005Metric
C16: 100p; C_0201_0603Metric
D1, D2, D4, D5: LED; LED_0402_1005Metric
D3: SMF5.0A; D_SOD-123F
J1: DF65-3P; DF653P17V78; Manufacturer_Part_Number DF65-3P-1.7V(78); Mouser Part Number 798-DF65-3P-1.7V(78)
J3: DF65; DF65-4P
J5: 0533091070
J7: pin_header; PinHeader_2x06_P1.27mm_Vertical
L1: 22u; SRN3015
R1, R2, R3, R4: 1k; R_0201_0603Metric
R5, R7: 10k; R_0201_0603Metric
R6: 20k; R_0201_0603Metric
R8: 15k; R_0201_0603Metric
SW1: TVAF06-A020B-R; TVAF06A020BR
U1: STSPIN32F0A; QFN50P700X700X105-49N-D; Manufacturer_Part_Number STSPIN32F0A; Mouser Part Number 511-STSPIN32F0A

Connections:
+3.3V: C3.1, C6.1, C8.1, C10.1, J3.1, J7.1, L1.1, R2.1, U1.10 (VDDA), U1.48 (VDD); also elsewhere on the board
/ADC_BATT: R6.2, R7.1, U1.19 (PB1)
/ENC_A: J3.2, U1.11 (PA0)
/ENC_B: J3.3, U1.12 (PA1)
/HSU: U1.33 (HSU); also elsewhere on the board
/HSV: U1.29 (HSV); also elsewhere on the board
/HSW: U1.25 (HSW); also elsewhere on the board
/LED1: R3.1, U1.4 (PF0)
/LED2: R4.1, U1.39 (PA15)
/LSU: U1.36 (LSU); also elsewhere on the board
/LSV: U1.32 (LSV); also elsewhere on the board
/LSW: U1.28 (LSW); also elsewhere on the board
/NRST: C12.1, J7.10, SW1.2, U1.7 (NRST)
/OC_COMP: C16.1, R8.2, U1.24 (OC_COMP)
/OP_1N: U1.22 (OP1N); also elsewhere on the board
/OP_1O: U1.13 (PA2), U1.21 (OP1O); also elsewhere on the board
/OP_1P: U1.23 (OP1P); also elsewhere on the board
/OP_2N: U1.2 (OP2N); also elsewhere on the board
/OP_2O: U1.3 (OP2O), U1.14 (PA3); also elsewhere on the board
/OP_2P: U1.1 (OP2P); also elsewhere on the board
/OP_3N: U1.46 (OP3N); also elsewhere on the board
/OP_3O: U1.15 (PA4), U1.47 (OP3O); also elsewhere on the board
/OP_3P: U1.45 (OP3P); also elsewhere on the board
/OUTU: C13.1, J1.1, U1.34 (OUTU); also elsewhere on the board
/OUTV: C14.2, J1.2, U1.30 (OUTV); also elsewhere on the board
/OUTW: C15.1, J1.3, U1.26 (OUTW); also elsewhere on the board
/SPI_CS: J5.4, U1.5 (PF1)
/SPI_MISO: J5.1, U1.17 (PA6)
/SPI_MOSI: J5.3, U1.18 (PA7)
/SPI_SCK: J5.2, U1.16 (PA5)
/SWCLK: J7.4, U1.38 (PA14_SWD_CLK)
/SWDIO: J7.2, U1.37 (PA13_SWD_IO)
/USART_RX: J7.11, U1.41 (PB7)
/USART_TX: J7.12, U1.40 (PB6)
/half_bridge2/INP: R8.1; also elsewhere on the board
GND: C1.2, C2.2, C3.2, C4.2, C5.2, C6.2, C7.2, C8.2, C9.2, C10.2, C11.2, C12.2, C16.2, D1.1 (K), D2.1 (K), D3.2 (A), D4.1 (K), D5.1 (K), J1.MP1, J1.MP2, J3.4, J5.6, J5.8, J5.10, J7.3, J7.5, J7.9, R5.1, R7.2, SW1.1, U1.20 (TESTMODE), U1.44 (GND), U1.49 (EPAD); also elsewhere on the board
unnamed: D1.2 (A), R1.2
unnamed: D2.2 (A), R2.2
unnamed: D3.1 (K), L1.2, U1.9 (SW)
unnamed: D4.2 (A), R3.2
unnamed: D5.2 (A), R4.2
unnamed: R5.2, U1.42 (BOOT0)
unnamed: C13.2, U1.35 (VBOOTU)
unnamed: C14.1, U1.31 (VBOOTV)
unnamed: C15.2, U1.27 (VBOOTW)
VDD: C1.1, C2.1, C4.1, C5.1, C7.1, C9.1, C11.1, J5.5, J5.7, J5.9, R1.1, R6.1, U1.6 (VREG12), U1.8 (VM); also elsewhere on the board

Notes on the sheet:
RC Filter
MCU & Gate Driver
Connector
Voltage Sense
Battery & SPI
Half Bridge
Debug
Encoder
Motor

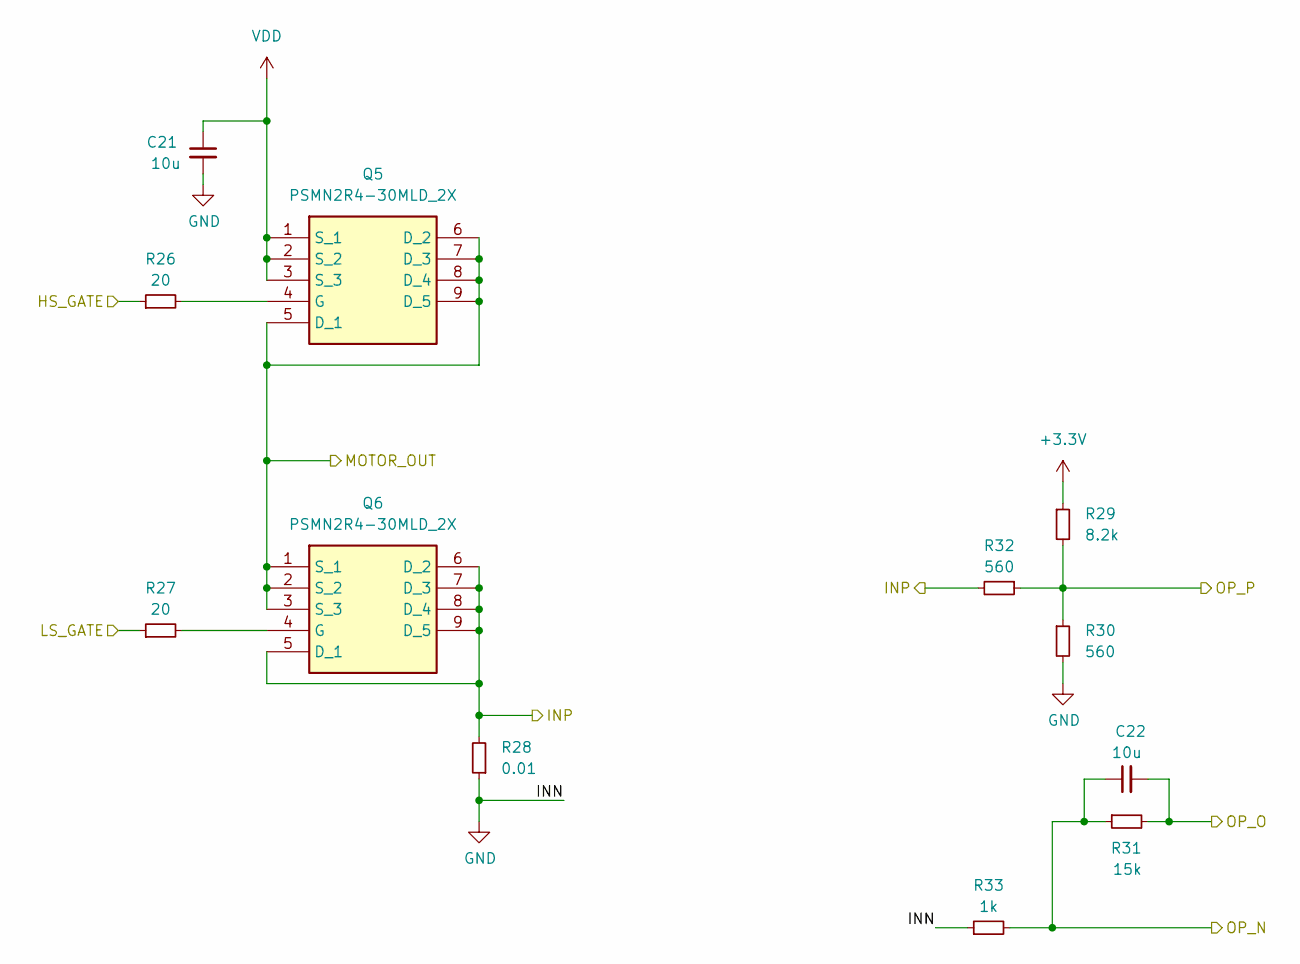
[picture p21: schematic half_bridge.kicad_sch]

Parts:
C21: 10u; C_0805_2012Metric
C22: 10u; C_0402_1005Metric
Q5, Q6: PSMN2R4-30MLD_2X; PSMN02030MLCX; Manufacturer_Part_Number PSMN2R4-30MLD/2X
R26, R27: 20; R_0402_1005Metric
R28: 0.01; R_0805_2012Metric
R29: 8.2k; R_0201_0603Metric
R30, R32: 560; R_0201_0603Metric
R31: 15k; R_0201_0603Metric
R33: 1k; R_0201_0603Metric

Connections:
+3.3V: R29.1; also elsewhere on the board
/HSW: R26.1; also elsewhere on the board
/LSW: R27.1; also elsewhere on the board
/OP_3N: C22.1, R31.1, R33.2; also elsewhere on the board
/OP_3O: C22.2, R31.2; also elsewhere on the board
/OP_3P: R29.2, R30.1, R32.1; also elsewhere on the board
/OUTW: Q5.5 (D_1), Q5.6 (D_2), Q5.7 (D_3), Q5.8 (D_4), Q5.9 (D_5), Q6.1 (S_1), Q6.2 (S_2), Q6.3 (S_3); also elsewhere on the board
/half_bridge2/INP: Q6.5 (D_1), Q6.6 (D_2), Q6.7 (D_3), Q6.8 (D_4), Q6.9 (D_5), R28.2, R32.2; also elsewhere on the board
GND: C21.2, R28.1, R30.2, R33.1; also elsewhere on the board
unnamed: Q5.4 (G), R26.2
unnamed: Q6.4 (G), R27.2
VDD: C21.1, Q5.1 (S_1), Q5.2 (S_2), Q5.3 (S_3); also elsewhere on the board

Parts of its further copies:
C17, C19: 10u; C_0805_2012Metric
C18, C20: 10u; C_0402_1005Metric
Q1, Q2, Q3, Q4: PSMN2R4-30MLD_2X; PSMN02030MLCX; Manufacturer_Part_Number PSMN2R4-30MLD/2X
R10, R11, R18, R19: 20; R_0402_1005Metric
R12, R20: 0.01; R_0805_2012Metric
R13, R21: 8.2k; R_0201_0603Metric
R14, R16, R22, R24: 560; R_0201_0603Metric
R15, R23: 15k; R_0201_0603Metric
R17, R25: 1k; R_0201_0603Metric

Connections of its further copies:
+3.3V: R13.1, R21.1; also elsewhere on the board
/HSU: R18.1; also elsewhere on the board
/HSV: R10.1; also elsewhere on the board
/LSU: R19.1; also elsewhere on the board
/LSV: R11.1; also elsewhere on the board
/OP_1N: C20.1, R23.1, R25.2; also elsewhere on the board
/OP_1O: C20.2, R23.2; also elsewhere on the board
/OP_1P: R21.2, R22.1, R24.1; also elsewhere on the board
/OP_2N: C18.1, R15.1, R17.2; also elsewhere on the board
/OP_2O: C18.2, R15.2; also elsewhere on the board
/OP_2P: R13.2, R14.1, R16.1; also elsewhere on the board
/OUTU: Q3.5 (D_1), Q3.6 (D_2), Q3.7 (D_3), Q3.8 (D_4), Q3.9 (D_5), Q4.1 (S_1), Q4.2 (S_2), Q4.3 (S_3); also elsewhere on the board
/OUTV: Q1.5 (D_1), Q1.6 (D_2), Q1.7 (D_3), Q1.8 (D_4), Q1.9 (D_5), Q2.1 (S_1), Q2.2 (S_2), Q2.3 (S_3); also elsewhere on the board
/half_bridge1/INP: Q2.5 (D_1), Q2.6 (D_2), Q2.7 (D_3), Q2.8 (D_4), Q2.9 (D_5), R12.2, R16.2
/half_bridge/INP: Q4.5 (D_1), Q4.6 (D_2), Q4.7 (D_3), Q4.8 (D_4), Q4.9 (D_5), R20.2, R24.2
GND: C17.2, C19.2, R12.1, R14.2, R17.1, R20.1, R22.2, R25.1; also elsewhere on the board
unnamed: Q1.4 (G), R10.2
unnamed: Q2.4 (G), R11.2
unnamed: Q3.4 (G), R18.2
unnamed: Q4.4 (G), R19.2
VDD: C17.1, C19.1, Q1.1 (S_1), Q1.2 (S_2), Q1.3 (S_3), Q3.1 (S_1), Q3.2 (S_2), Q3.3 (S_3); also elsewhere on the board

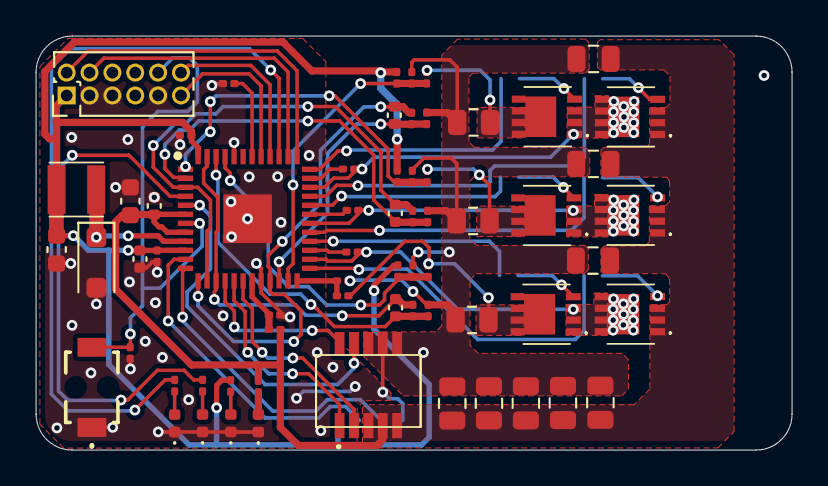
[picture p22: board blmd.kicad_pcb from above]

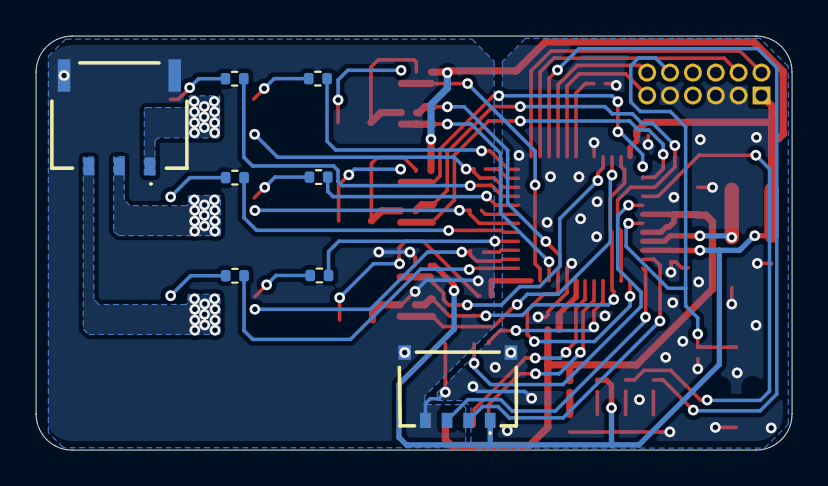
[picture p23: board blmd.kicad_pcb from below]

Board: 2 copper layers, 42.0 x 23.0 mm, 72 parts (8 on the bottom side), 54 nets.
